CHIPKIT3DP-TEAM/mchp_kossel/shield pinout.ods

Sheet: Shield
CHIPKIT RAMPS MINI
chipKIT Pin # | Connector Pin # | PIN# | WIFIRE Signal | UNO32 Signal | RAMP Signal | Notes | Ramps mini HW | HW Design Notes
0 | J6-01 | 57 | RF2,GPIO,U4RX | U1RX/SDI1/RF2 |  |  | 4x A4983 Steppers | Steppers are configured 16 micro steps
1 | J6-03 | 58 | RF8,GPIO,U4TX | U1TX/SDO1/RF3 |  |  | 1x 24AA08 EEPROM | All steppers are enabled together
2 | J6-05 | 18 | RE8,GPIO,IC1,INT1 | IC1/RTCC/INT1/RD8 | Dir A |  | 1x MCP47FEB02 2-chn DAC | All steppers are reset from RESET
3 | J6-07 | 71 | RD0,PWM1, INT0,OC1 | OC1/RD0 | Step A | Output compare for step generator | 4x MCP87055 MOSFETs | Output Compares are reserved for the steppers
4 | J6-09 | 60 | RA3,GPIO | RF1 | Dir B | 3.3v GPIO | 3x FSR Inputs | 1 PWM is available for the print fan
5 | J6-11 | 76 | RD1,PWM2, OC2 | OC2/RD1 | Step B | Output compare for step generator | 2x Thermistor Inputs | 1 GPIO is available for the hot end fan (no pwm on uno32)
6 | J6-13 | 77 | RD2,PWM3, OC3 | OC3/RD2 | Step C | Output compare for step generator | 3x Limit Inputs (5v drive) | Thermistors are pulled up to 3.3v
7 | J6-15 | 19 | RE9,GPIO,IC2,INT2 | IC2/U1CTS/INT2/RD9 | Dir C | 3.3v GPIO | 1x Servo Inputs (5v power) | Servo is pulled up to 5v
8 | J5-01 | 66 | RA14,GPIO,IC3,INT3 | IC3/PMCS2/PMA15/INT3/RD10 | Dir E | 3.3v GPIO | Legacy LCD Ctrl support | FSR's and endstops are pulled up to 5v or 3.3v via jumper
9 | J5-03 | 78 | RD3,PWM4,OC4 | OC4/RD3 | Step E | Output compare for step generator | 1x MCP9800 near MOSFETS | DAC's to set motor current, separate motion / extruder
10 | J5-05 | 16 | RG9,SPI_SS2,PWM5,OC9,IC6 | (PMWR/OC5/IC5/CN13/RD4) or (SS2/PMA2/CN11/RG9) | Fan PWM | PWM For Fan Control | 1x MCP9800 near Steppers | Serial EEPROM for configuration
11 | J5-07 | 70 | RD11,SPI_SDO2/SDI2, PWM6, OC7 | (SDO2/PMA3/CN10/RG8) or (SDI2/PMA5/CN8/RG7) | SD SDO | SPI for LCD Display |  | 1 serial expansion bus for extra hot-ends
12 | J5-09 | 85 | RF0,SPI_SDI2/SDO2,T5CK(+) | (SDI2/PMA5/CN8/RG7) or (SDO2/PMA3/CN10/RG8) | SD SDI | Could be SPI controlled TFT with Touch
13 | J5-11 | 10 | RG6,SPI_SCK2,USER_LED1 | SCK2/PMA5/CN8/RG6 | SD SCK | Or it could be Ultimachine 4 line display with buttons
14/A0 | J7-01 | 20 | RB5,AN45,GPIO | C2IN-/AN2/SS1/CN4/RB2 | SD nCS
15/A1 | J7-03 | 33 | RB9,AN49,GPIO | C1IN-/AN4/CN6/RB4 | Bed Thermistor
16/A2 | J7-05 | 7 | RC2,AN21,GPIO | U2CTS/C1OUT/AN8/RB8 | Hot End Thermistor
17/A3 | J7-07 | 44 | RB15,AN10 | TMS/CVREFOUT/PMA13/AN10/RB10 | SDA / SD DETECT | Crazy jumpers required | I2C has 3.3v pullup
18/A4 | J7-09 | 11 | RG7,AN13,SDA | (TCK/PMA11/AN12/RB12) or (SDA1/RG3)(TCK/PMA11/AN12/RB12) or (SDA1/RG3) | SCL / SDA | to configure this I2C
19/A5 | J7-11 | 12 | RG8,AN12,GPIO,SCL | (PMALH/PMA1/U2RTS/AN14/RB14) or (SCL1/RG2)(PMALH/PMA1/U2RTS/AN14/RB14) or (SCL1/RG2) | SD DETECT / SCL
20/A6 | J7-02 | 22 | RB3,AN3,GPIO | C2IN+/AN3/CN5/RB3 | FSR / Min A | ADC inputs to Force Sensing Resistors | FSR's & Thermistors have 3.3v pullups
21/A7 | J7-04 | 23 | RB2,AN2,GPIO | C1IN+/AN5/CN7/RB5 | FSR / Min B | ADC inputs to Force Sensing Resistors
22/A8 | J7-06 | 21 | RB4,AN4,GPIO | PMA7/C2OUT/AN9/RB9 | FSR / Min C | ADC inputs to Force Sensing Resistors
23/A9 | J7-08 | 24 | RB1,AN1,GPIO | TDO/PMA12/AN11/RB11 | Encoder 0 / LCD Touch X | Resistive Touch Screen Input
24/A10 | J7-10 | 32 | RB8,AN48,GPIO, P32_VBUS_ON | TDI/PMA10/AN13/RB13 | Encoder 1 / LCD Touch Y | Resisitive Touch Screen Input
25/A11 | J7-12 | 25 | RB0,AN0,GPIO | PMALL/PMA0/AN15/OCFB/CN12/RB15 | Encoder Select
26 | J6-02 | 91 | RE0,PMD0 | PMD0/RE0 | LCD D4
27 | J6-04 | 94 | RE1,PMD1 | PMD1/RE1 | LCD D5
28 | J6-06 | 98 | RE2,PMD2 | PMD2/RE2 | LCD D6
29 | J6-08 | 99 | RE3,PMD3 | PMD3/RE3 | LCD D7
30 | J6-10 | 100 | RE4,PMD4 | PMD4/RE4 | LCD RS
31 | J6-12 | 3 | RE5,PMD5 | PMD5/RE5 | LCD EN
32 | J6-14 | 4 | RE6,PMD6 | PMD6/RE6 | Servo
33 | J6-16 | 5 | RE7,PMD7 | PMD7/RE7 | Stepper Enable
34 | J5-02 | 82 | RD5,GPIO, T4CK | PMRD/CN14/RD5 | Max C
35 | J5-04 | 6 | RC1,GPIO, T2CK, IC7 | IC4/PMCS1/PMA14/INT4/RD11 | Max B
36 | J5-06 | 86 | RF1,GPIO, T6CK | CN15/RD6 | Max A
37 | J5-08 | 59 | RA2,GPIO | CN16/RD7 | Fan DC
38 | J5-10 | 79 | RD12,GPIO, T3Ck | U1RTS/BCLK1/SCK1/INT0/RF6 | Heater Bed
39 | J5-12 | 47 | RD14,GPIO,U1RX | PMA9/U2RX/SDA2/CN17/RF4 | Serial Bus Expansion RX | 3-pin & Display Connector | Question… Should serial expansion be differential (485)
40 | J5-14 | 48 | RD15,GPIO, U1TX | PMA8/U2TX/SCL2/CN18/RF5 | Serial Bus Expansion TX |  | If YES, should DE & RE be connected to SDI/SDO for when digipots are not being talked to.
41 | J5-16 | 28 | RA9,GPIO, VREF- | PGC1/AN1/VREF-/CVREF-/CN3/RB1 | Heater Extr |  | I.E. you cannot talk to the BUS & the Digipot at the same time.
42 | J5-15 | 29 | RA10,VREF+ | PGED1/PMA6/AN0/VREF+/CVREF+/CN2/RB0 | Vdd/4 | Thermistor GAIN
43 |  | 81 | RD4,USER_LED2 | RF0

Sheet: WiFire
pin | shield | onboard | 3dp
TMS/EBIA16/AN24/RA0 |  | JP3-JTAG
TCK/EBIA19/AN29/RA1 |  | JP3-JTAG
EBICS0/SCL2/RA2 | J7-D37 |  | FAN_DC
EBIRDY1/SDA2/RA3 | J10-D4 |  | DIR_B
EBIA14/PMCS1/PMA14/RA4 |  | BTN2
EBIA5/AN34/PMA5/RA5 |  | BTN1
TRCLK/SQICLK/RA6 |  | JP4-TRACE
TRD3/SQID3/RA7 |  | JP4-TRACE
VREF-/CVREF-/AN27/AERXD2/RA9 | J7-D41 |  | HEAT_EXT
VREF+/CVREF+/AN28/AERXD3/RA10 | J7-AREF |  | AREF
AETXCLK/RPA14/SCL1/RA14 | J7-D8 | VBUS OVC | DIR_E
AETXEN/RPA15/SDA1/RA15 |  | MRF-INT
PGED1/AN0/RPB0/RB0 | J8-A11 | VBUS-EN | ENC_SEL
PGEC1/AN1/RPB1/RB1 | J8-A9 |  | ENC_0
AN2/C2INB/RPB2/RB2 | J8-A7 |  | MIN_B
AN3/C2INA/RPB3/RB3 | J8-A6 |  | MIN_A
AN4/C1INB/RB4 | J8-A8 |  | MIN_C
AN45/C1INA/RPB5/RB5 | J8-A0 |  | SD_CS
PGEC2/AN46/RPB6/RB6 |  | PGC
PGED2/AN47/RPB7/RB7 |  | PGD
EBIA10/AN48/RPB8/PMA10/RB8 | J8-A10 |  | ENC_1
EBIA7/AN49/RPB9/PMA7/RB9 | J8-A1 |  | THERMO_BED
EBIA13/CVREFOUT/AN5/RPB10/PMA13/RB10 |  | SD-SDI
AN6/ERXERR/AETXERR/RB11 |  | LED3
EBIA11/AN7/ERXD0/AECRS/PMA11/RB12 |  | VBUS SNS
AN8/ERXD1/AECOL/RB13 |  | POT-VR1
EBIA1/AN9/ERXD2/AETXD3/RPB14/SCK3/PMA1/RB14 |  | SD-SCK
EBIA0/AN10/ERXD3/AETXD2/RPB15/OCFB/PMA0/RB15 | J8-A3 |  | SD_DETECT
EBIA6/AN22/RPC1/PMA6/RC1 | J7-D35 |  | MAX_B
EBIA12/AN21/RPC2/PMA12/RC2 | J8-A2 |  | THERMO_EXT
EBIWE/AN20/RPC3/PMWR/RC3 |  | SD-CS
EBIOE/AN19/RPC4/PMRD/RC4 |  | SD-SDO
OSC1/CLKI/RC12 |  | POSC
SOSCI/RPC13/RC13 |  | SOSC
SOSCO/RPC14/T1CK/RC14 |  | SOSC
OSC2/CLKO/RC15
EMDIO/AEMDIO/RPD0/RTCC/INT0/RD0 | J10-D3 |  | STEP_A
RPD1/SCK1/RD1 | J10-D5 |  | STEP_B
EBID14/ETXEN/RPD2/PMD14/RD2 | J10-D6 |  | STEP_C
EBID15/ETXCLK/RPD3/PMD15/RD3 | J7-D9 |  | STEP_E
SQICS0/RPD4/RD4 |  | LED2
SQICS1/RPD5/RD5 | J7-D34 |  | MAX_C
EBIA15/RPD9/PMCS2/PMA15/RD9 |  | MRF-CS
RPD10/SCK4/RD10 |  | MRF-SCK
EMDC/AEMDC/RPD11/RD11 | J7-D11 | J9-SPI | SPI_SDO
EBID12/ETXD2/RPD12/PMD12/RD12 | J7-D38 |  | HEAT_BED
EBID13/ETXD3/PMD13/RD13 |  | EN-EXT
AN32/AETXD0/RPD14/RD14 | J7-D39 |  | BUS_RX
AN33/AETXD1/RPD15/SCK6/RD15 | J7-D40 |  | BUS_TX
EBID0/PMD0/RE0 | J10-D26 |  | LCD_D4
EBID1/PMD1/RE1 | J10-D27 |  | LCD_D5
EBID2/PMD2/RE2 | J10-D28 |  | LCD_D6
EBID3/RPE3/PMD3/RE3 | J10-D29 |  | LCD_D7
EBID4/AN18/PMD4/RE4 | J10-D30 |  | LCD_RS
EBID5/AN17/RPE5/PMD5/RE5 | J10-D31 |  | LCD_EN
EBID6/AN16/PMD6/RE6 | J10-D32 |  | SERVO
EBID7/AN15/PMD7/RE7 | J10-D33 |  | STEPPER_EN
AN25/AERXD0/RPE8/RE8 | J10-D2 |  | DIR_A
AN26/AERXD1/RPE9/RE9 | J10-D7 |  | DIR_C
EBID11/ETXD1/RPF0/PMD11/RF0 | J7-D12 | J9-SPI | SPI_SDI
EBID10/ETXD0/RPF1/PMD10/RF1 | J7-D36 |  | MAX_A
EBIRDY3/RPF2/SDA3/RF2 | J10-D0 | FTDI-RX
USBID/RPF3/RF3 |  | USB-ID
EBIA9/RPF4/SDA5/PMA9/RF4 |  | MRF-RST
EBIA8/RPF5/SCL5/PMA8/RF5 |  | MRF-SDI
EBIRDY2/RPF8/SCL3/RF8 | J10-D1 | FTDI-TX
TDO/EBIA17/AN31/RPF12/RF12 |  | JP3-JTAG
TDI/EBIA18/AN30/RPF13/SCK5/RF13 |  | JP3-JTAG
EBID8/RPG0/PMD8/RG0 |  | MRF-SDO
EBID9/ETXERR/RPG1/PMD9/RG1 |  | MRF-PD
AN14/C1IND/ECOL/RPG6/SCK2/RG6 | J7-D13 | J9-SPI / LED1 | SPI_SCK
EBIA4/AN13/C1INC/ECRS/RPG7/SDA4/PMA4/RG7 | J6-A4 | J6-I2C | I2C_SDA
EBIA3/AN12/C2IND/ERXDV/ECRSDV/AERXDV/AECRSDV/RPG8/SCL4/PMA3/RG8 | J6-A5 | J6-I2C | I2C_SCL
EBIA2/AN11/C2INC/ERXCLK/EREFCLK/AERXCLK/AEREFCLK/RPG9/PMA2/RG9 | J7-D10 | J9-SPI | FAN_PWM
TRD1/SQID1/RG12 |  | JP4-TRACE
TRD0/SQID0/RG13 |  | JP4-TRACE
TRD2/SQID2/RG14 |  | JP4-TRACE
AN23/AERXERR/RG15 |  | LED4
