CHIPKIT3DP-TEAM/mchp_kossel/board/output/shield3dp-A0.bom.pdf

| Value | Count | Source
A4988 QFN | A4988SETTR-T | 4
BTN 6X6 | | 1
CAP C 0603 | 0.1u | 14
CAP C 0603 | 0.33u | 4
CAP C 0603 | 1u | 7
CAP C 0603 | 1u 16V | 8
CAP C 0603 | 10n | 8
CAP C 0805 | 10u | 4
CAP C 1206 | 1u 25V | 1
CAP C 1206 | 10u 16V | 1
CAP E THM200 D400 | 470u 16V | 1
LED 0603 | | 2
MCP47FEBX2 | MCP47FEB02A0T-E/ST | 1 | MCHP
MCP87XXX 3.3X3.3 | MCP87055T-U/LC | 4 | MCHP
MCP980X SOT23-5 | MCP9800A0T-M/OT | 1 | MCHP
MCP98244 | MCP98244T-BE/MNY | 1 | MCHP
NPN SOT23 | BC847C | 1
PIN100 2 | | 3
PIN100 2 | THERMO | 2
PIN100 3 | ENDSTOP | 6
PIN100 3 | | 4
PIN100 4 | STEPPER | 4
PIN100 5X2 | EXPANSION | 2
PIN100 6 | POWER | 1
PIN100 6X2 | ANALOG | 1
PIN100 8X2 | IOH | 1
PIN100 8X2 | IOL | 1
PIN150 2 | FAN | 2
PIN150 3 | BUS | 1
PIN200 2 | HIGH POWER | 3
RES 0603 | 0.1 | 8 | DIGIKEY 1276-6155-1-ND
RES 0603 | 1K | 4
RES 0603 | 3.3K | 3
RES 0603 | 4.7K | 8
RES 0603 | 10K | 5
RES 0603 | 100 | 7
FUSE THM200 | 15V 8A | 1
FUSE THM400 | 15V 15A | 1
SHOTTKY 0603 | 20V 200mA | 4
SHOTTKY SMD200 | 20V 5A | 3

ComponentName

DigiKey 620-1343-1-ND

DigiKey WM4800-ND + WM2900-ND DigiKey WM4801-ND + WM2901-ND

DigiKey WM4802-ND + WM2902-ND

DigiKey 507-1309-ND
DigiKey RGEF1400-ND
DigiKey 478-7798-1-ND
DigiKey DB2431200LCT-ND
