CHIPKIT3DP-TEAM/mchp_kossel/3D_Kossel_Hardware_BOM.ods

Sheet: Summary
Item | Discription | QTY | Base cost | Total | Weight (KG) | SKU | Link
1 | Tr8*8 500mm Leadscrew Threaded Stepper | 3 | $51.00 | $153.00 | 0.41 |  | http://www.robotdigg.com/product/227/500mm-Tr8*8-Lead-Screw-Threaded-Nema17-40mm-Stepper
2 | All Metal hotend w/0.4mm nozzle for 1.75mm filament | 1 | $36.00 | $36.00 | 0.1 | S0004 | http://www.robotdigg.com/product/182/All-metal-hotend-w/-0.4mm-nozzle-for-1.75mm-filament
3 | Tie Rod n Ball Joint Pack Set (12pcs) | 1 | $7.00 | $7.00 | 0.01 | DR001 | http://www.robotdigg.com/product/75/Tie-Rod-n-Ball-Joint-Pack-Set
4 | China Made MGN-12H L400 hardened Steel Rail and Carriage for Kossel | 1 | $58.00 | $58.00 | 1.4 | DR009 | http://www.robotdigg.com/product/164/China-Made-MGN-12H-L400-hardened-Steel-Rail-and-Carriage-for-Kossel
5 | Post Assembly T Nuts for 2020 Aluminum Extrustion (100pcs) (Request M4) | 1 | $7.50 | $7.50 | 0.1 | DR015 | http://www.robotdigg.com/product/237/Post-Assembly-T-Nuts-for-2020-Aluminum-Extrusion
6 | Post Assembly T Nuts for 2020 Aluminum Extrustion (100pcs) (Request M3) | 1 | $7.50 | $7.50 | 0.1 | DR015 | http://www.robotdigg.com/product/237/Post-Assembly-T-Nuts-for-2020-Aluminum-Extrusion
7 | Carbon Fiber Tube, 5mm OD, 3mm ID, 180mm L (6pcs) | 1 | $5.00 | $5.00 | 0.01 | DR007 | http://www.robotdigg.com/product/187/Carbon-Fiber-Tube,-5mm-OD,-3mm-ID,-180mm-L-%286pcs%29
8 | 180mm round Silicone Ruber Heater Pad | 1 | $12.80 | $12.80 | 0.2 | DR016 | http://www.robotdigg.com/product/238/180mm-round-silicone-rubber-heater-pad
9 | 180mm Round Glass | 1 | $8.00 | $8.00 | 0.2 | DR013 | http://www.robotdigg.com/product/200/Round-Glass-180mm-for-Kossel-Mini
10 | 2020 OpenBeam (15mm x 15 mm) | 1 | $24.00 | $24.00 | 1.85 | DR011 | http://www.robotdigg.com/product/183/2020-OpenBeam-for-Kossel-Mini
11 | Optical Endstops w/ Lead Wires for 3D Printers | 3 | $2.00 | $6.00 | 0.01 | E001 | http://www.robotdigg.com/product/155/Optical-Endstop-w/-Lead-Wires-for-3D-Printers
12 | NEMA 17 40mm | 1 | $6.80 | $6.80 |  |  | http://www.robotdigg.com/product/7/NEMA17-Stepper-Motor-40mm-Long,-1.2A
13 | PTFE Tube 2mm ID, 3mm OD, 2M | 1 | $1.80 | $1.80 |  |  | http://www.robotdigg.com/product/93/ID-2mm,-OD-3mm-PTFE-Tube-2-Meters
14 | 8mm Spiral cable Wrap black or white (10 meters) | 1 | 1 | $1.00 |  |  | http://www.robotdigg.com/product/196/8mm-spiral-cable-wrap-black-or-white
15 | M3*4 Grub Screw Pack | 1 | $0.35 | $0.35 |  |  | http://www.robotdigg.com/product/17/M3*4-Grub-Screw-PACK-SET-for-Timing-Pulleys
16 | PC4-01 Pneumatic Connector (Must Request the -01) | 1 | 0.3 | $0.30 |  |  | http://www.robotdigg.com/product/135/PC4-M6-Pneumatic-Connector-for-Bowden-Extruder
17 | Hobbed M8 Bolt | 1 | $2.80 | $2.80 |  |  | http://www.robotdigg.com/product/156/Hobbed-M8-Bolt-for-Wade's-Extruder
18 | M4-0.7 x 12mm (100pcs) | 1 | $6.14 | $6.14 |  |  | http://www.amazon.com/gp/product/B00DD4UYQU?ref_=biss_dp_sa1&pldnSite=1
19 | M4-0.7 x 25mm (100pcs) | 1 | 6.6 | $6.60 |  |  | http://www.amazon.com/gp/product/B00DD4UYQU?ref_=biss_dp_sa1&pldnSite=1
20 | eTopLED 12v 15.5A Single Output Switching Low-cost Power Supply | 1 | $19.79 | $19.79 |  |  | http://www.amazon.com/gp/product/B00DR8V8DA?pldnSite=1
Sum Per Kit |  |  |  | $370.38
Number Of Kits |  |  |  | 1
Total |  |  |  | $370.38

Sheet: Screws
assembly | M4-8 | M4-12 | M4-25 | M3-8 | M3-20 | M3-70
spool holder |  | 4 | 1
extruder mount |  | 2
extruder motor |  |  |  | 4
top plate |  | 9
top corners |  | 12 | 6
end stops |  |  |  | 6
rails |  |  |  | 15
carriages |  |  |  | 15
beams |  |  |  |  | 12
hot end + fan mount |  |  |  |  |  | 4
fan |  |  |  |  | 4
building deck | 9
motors |  |  |  | 16
bottom corners |  | 24 | 24
PSU, fan |  |  |  | 4 | 4
bottom plate |  | 9
overall | 9 | 60 | 31 | 60 | 20 | 4
order | 10 | 100 | 50 | 100 | 25 | 5
