CHIPKIT3DP-TEAM/mchp_kossel/Printer/acrylic/large wall.dxf

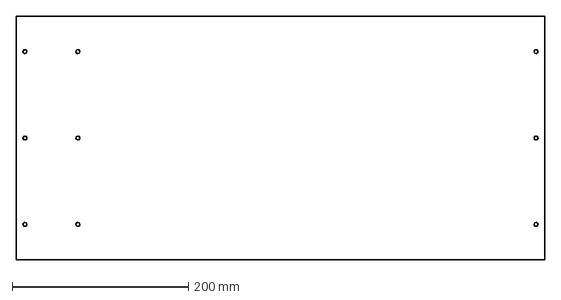
[picture p2: CAD file, 2015-05-05]
Printer/acrylic/large wall.dxf
600.0 x 276.1 mm
