CHIPKIT3DP-TEAM/mchp_kossel/Printer/effector/j-head mount.stl

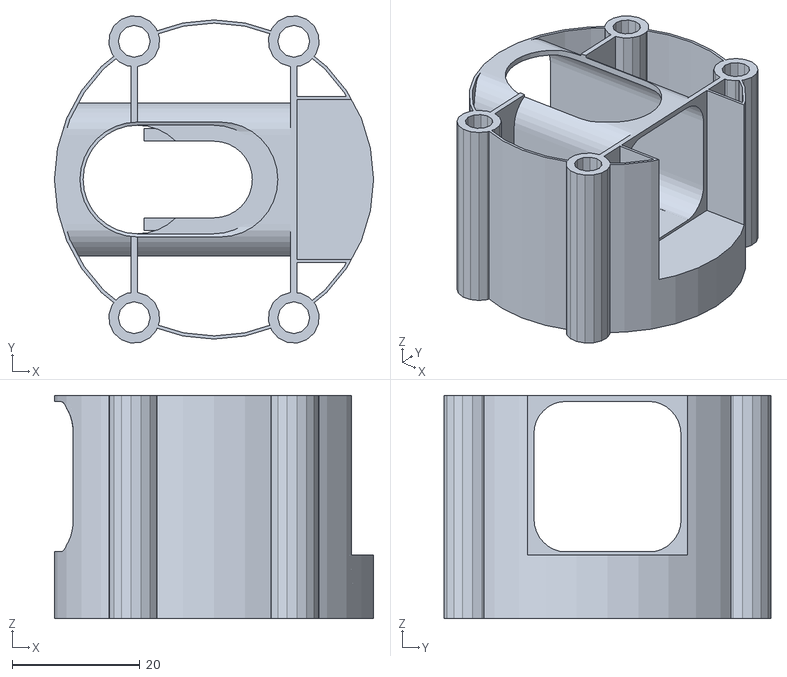
[picture p3: CAD file, 2015-08-30]
Printer/effector/j-head mount.stl
50.0 x 51.2 x 35.0
