CHIPKIT3DP-TEAM/mchp_kossel/Printer/extruder/extr_gear_big_43.stl

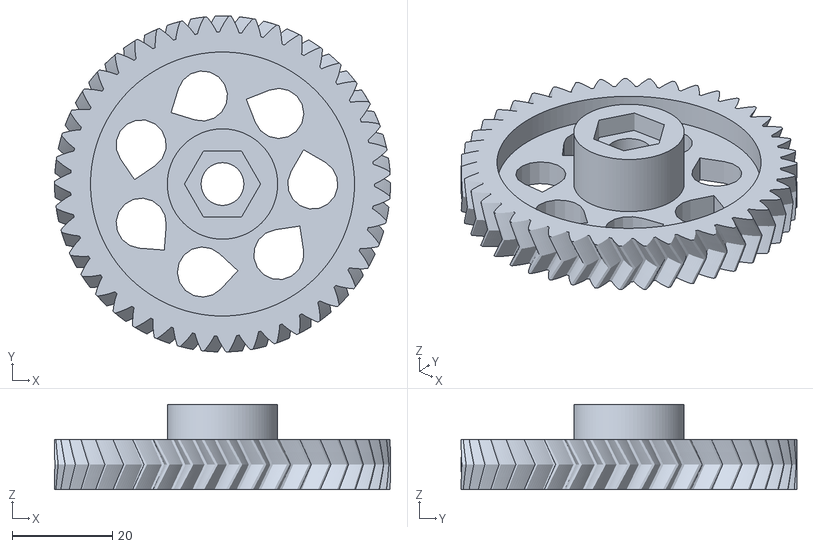
[picture p4: CAD file, 2015-06-20]
Printer/extruder/extr_gear_big_43.stl
67.0 x 67.0 x 17.0
