CHIPKIT3DP-TEAM/mchp_kossel/Printer/top corner notch.stl

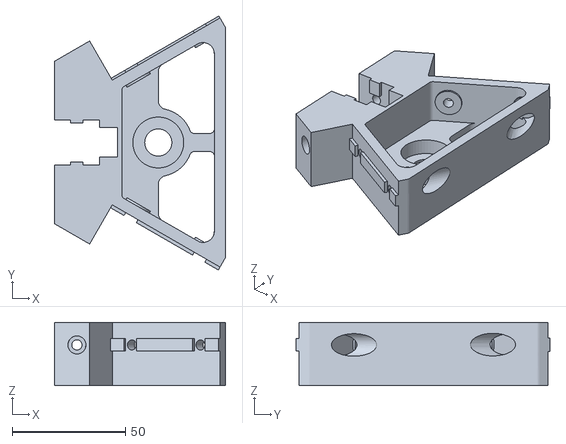
[picture p5: CAD file, 2015-08-12]
Printer/top corner notch.stl
75.8 x 112.3 x 28.0
