CHIPKIT3DP-TEAM/mchp_kossel/Printer/acrylic/insulator.dxf

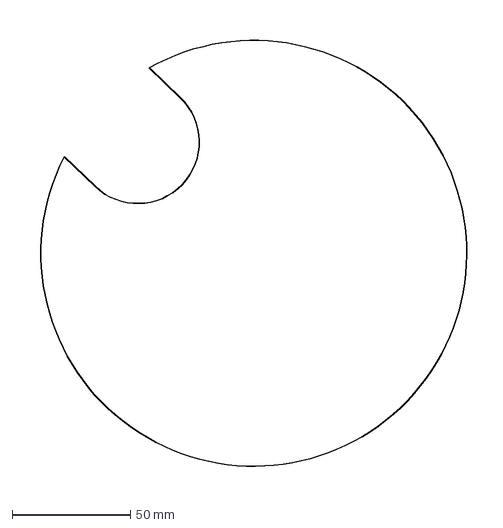
[picture p6: CAD file, 2015-05-05]
Printer/acrylic/insulator.dxf
198.9 x 199.5 mm
