CHIPKIT3DP-TEAM/mchp_kossel/Printer/cable clamp 5mm.stl

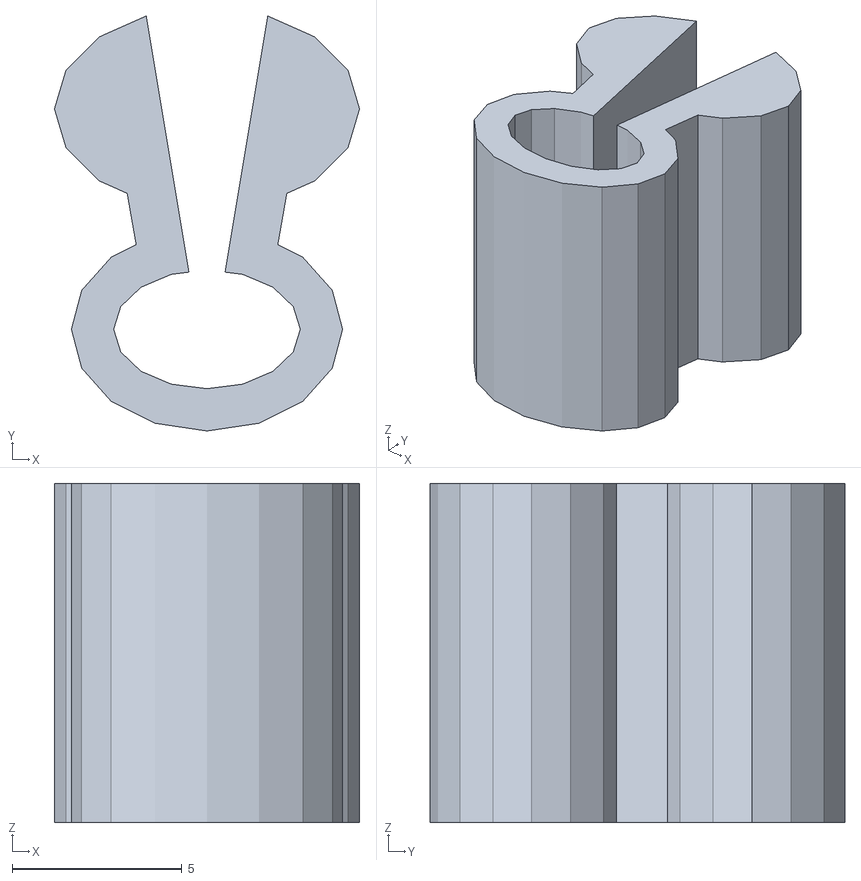
[picture p7: CAD file, 2015-05-14]
Printer/cable clamp 5mm.stl
9.00 x 12.2 x 10.0
