CHIPKIT3DP-TEAM/mchp_kossel/Printer/effector/ubis mount.stl

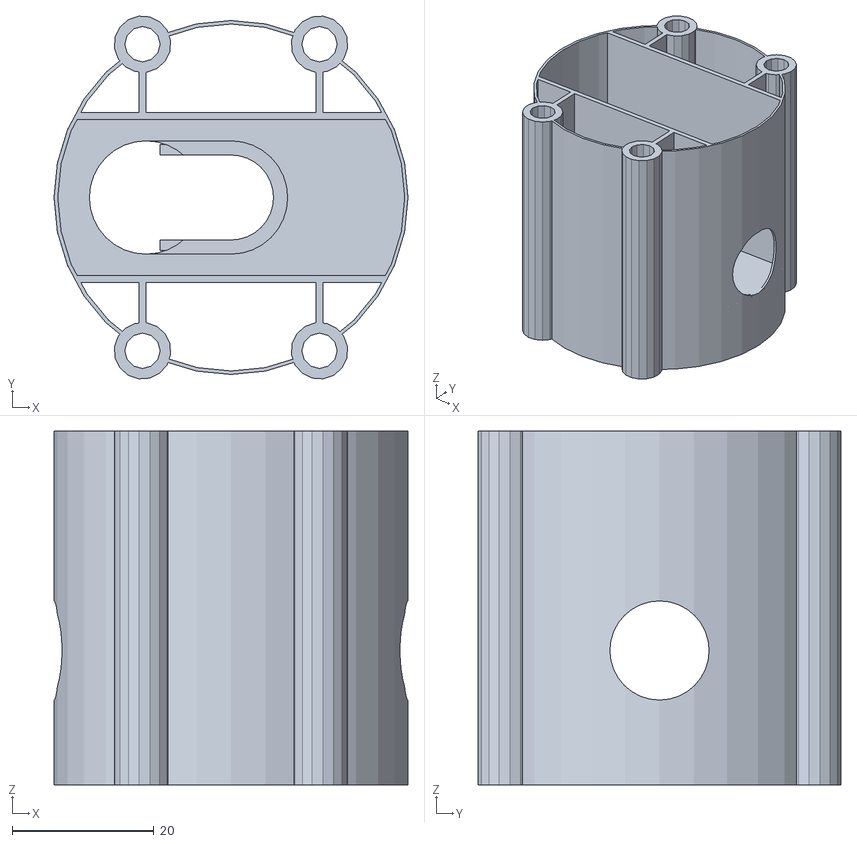
[picture p8: CAD file, 2015-08-30]
Printer/effector/ubis mount.stl
50.0 x 51.2 x 50.0
