CHIPKIT3DP-TEAM/mchp_kossel/Printer/extruder/extr_body.stl

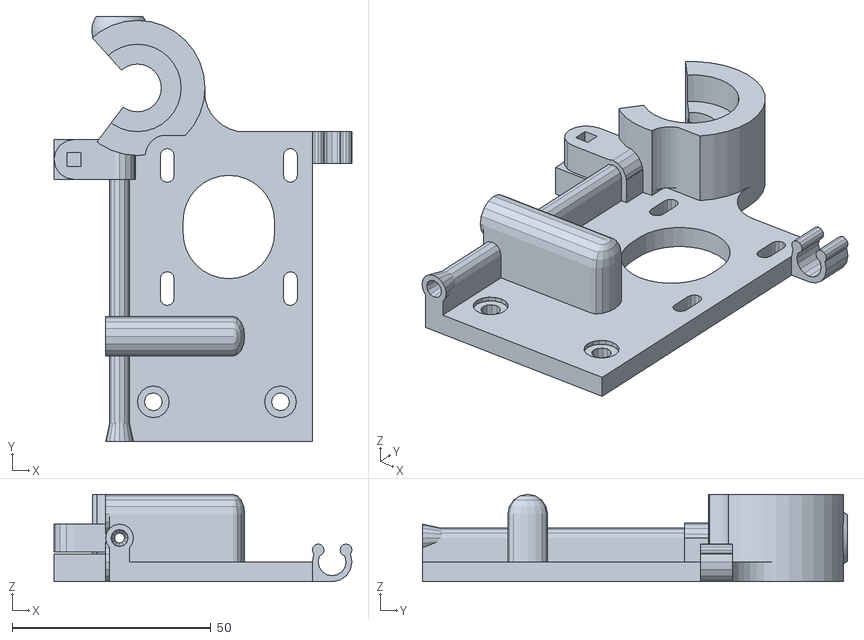
[picture p9: CAD file, 2015-06-02]
Printer/extruder/extr_body.stl
75.0 x 107.0 x 22.0
