CHIPKIT3DP-TEAM/mchp_kossel/Printer/acrylic/top plate.dxf

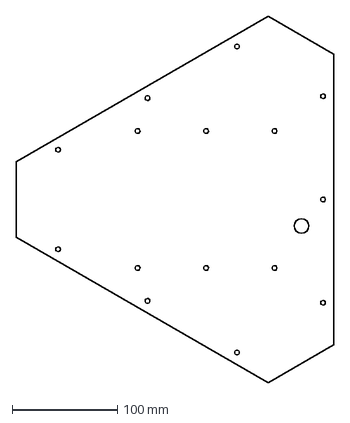
[picture p10: CAD file, 2015-05-05]
Printer/acrylic/top plate.dxf
301.2 x 347.8 mm
