CHIPKIT3DP-TEAM/mchp_kossel/Printer/cable clamp 10mm.stl

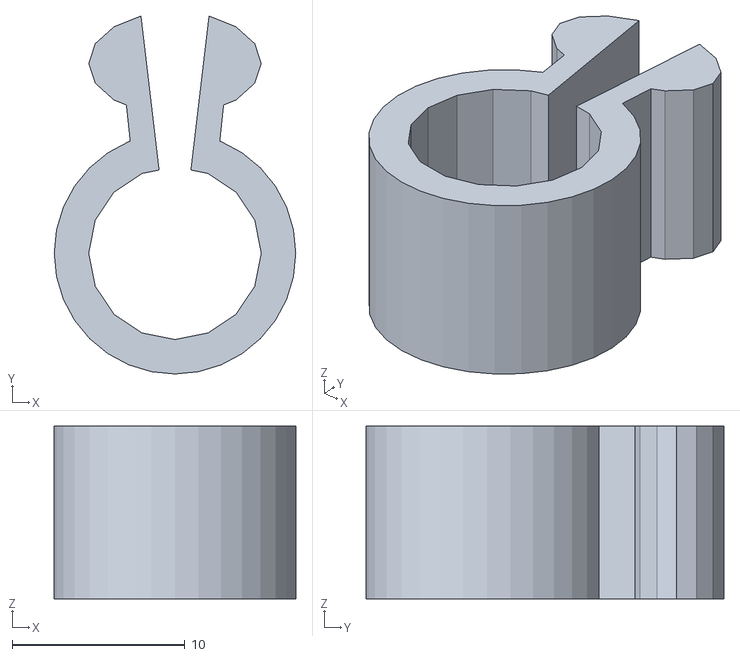
[picture p11: CAD file, 2015-05-12]
Printer/cable clamp 10mm.stl
14.0 x 20.7 x 10.0
