CHIPKIT3DP-TEAM/mchp_kossel/Printer/effector/effector plate.stl

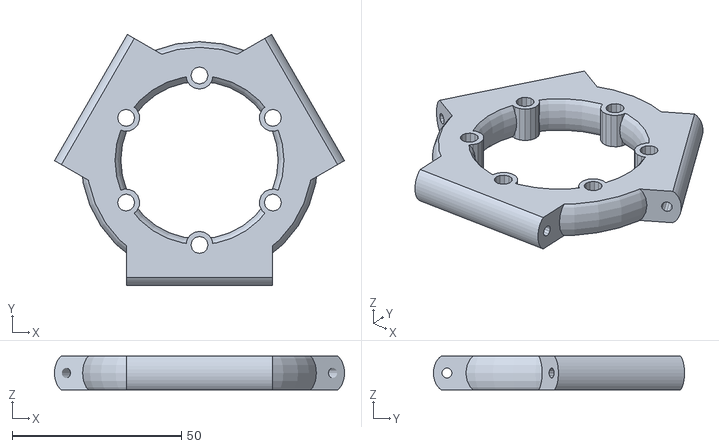
[picture p12: CAD file, 2015-08-30]
Printer/effector/effector plate.stl
85.6 x 74.1 x 9.99
