CHIPKIT3DP-TEAM/mchp_kossel/Printer/extruder/extr_gear_small_13.stl

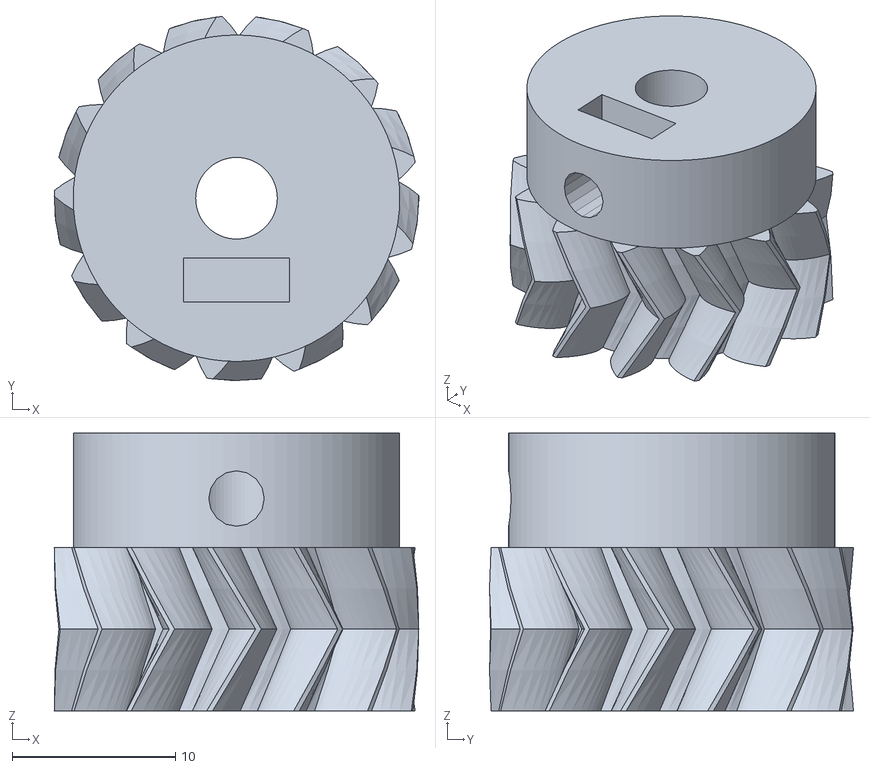
[picture p13: CAD file, 2015-05-12]
Printer/extruder/extr_gear_small_13.stl
22.3 x 22.3 x 17.0
