CHIPKIT3DP-TEAM/mchp_kossel/Printer/acrylic/build deck.dxf

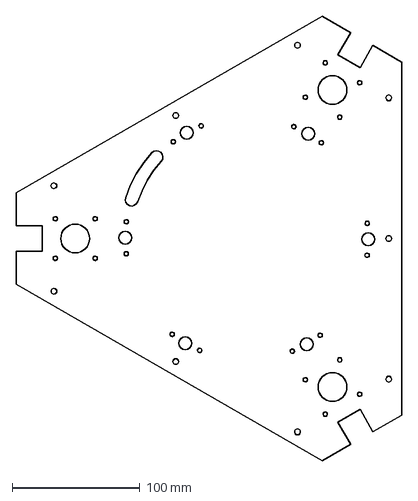
[picture p14: CAD file, 2015-05-05]
Printer/acrylic/build deck.dxf
301.2 x 347.8 mm
