CHIPKIT3DP-TEAM/mchp_kossel/Printer/carraige.stl

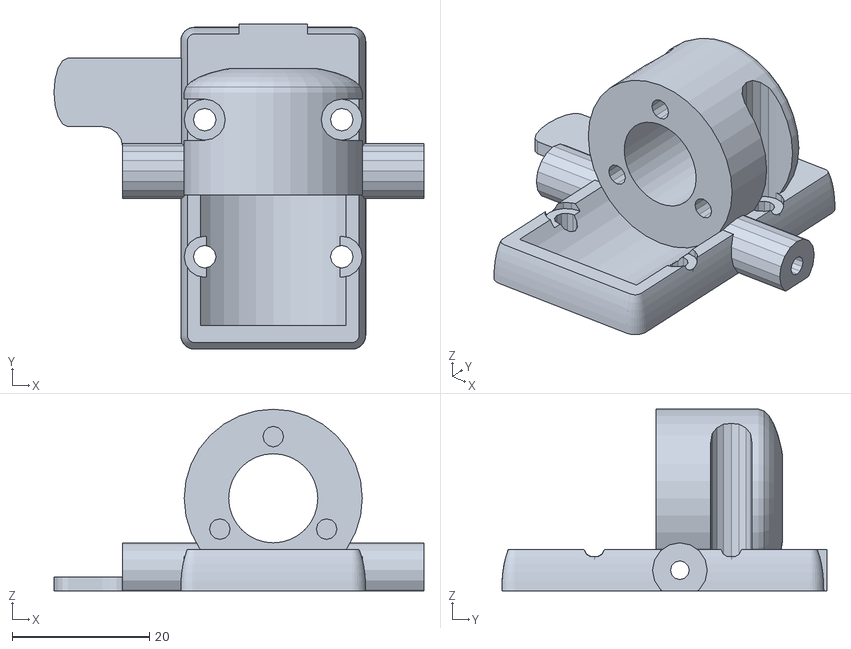
[picture p15: CAD file, 2015-05-12]
Printer/carraige.stl
54.0 x 47.5 x 26.5
