CHIPKIT3DP-TEAM/mchp_kossel/Printer/effector/e3d mount.stl

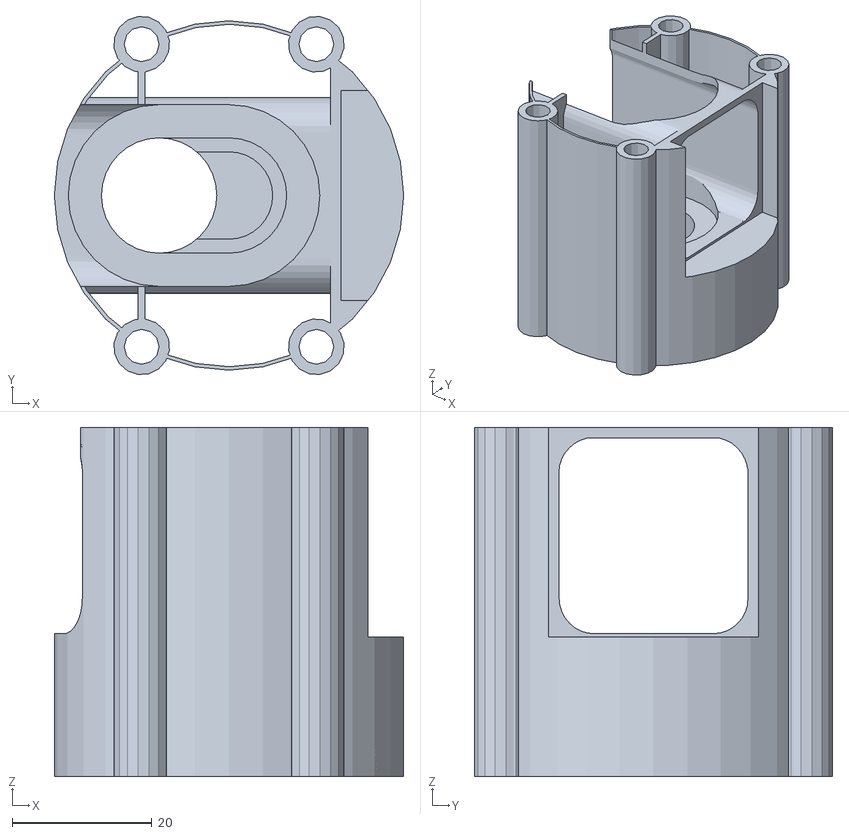
[picture p16: CAD file, 2015-08-30]
Printer/effector/e3d mount.stl
50.0 x 51.2 x 50.0
