CHIPKIT3DP-TEAM/mchp_kossel/Printer/extruder/extr_lever.stl

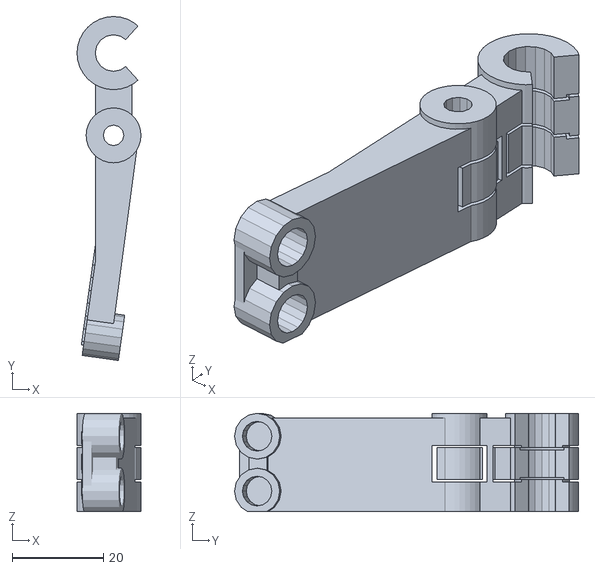
[picture p17: CAD file, 2015-02-27]
Printer/extruder/extr_lever.stl
14.0 x 75.3 x 21.5
