CHIPKIT3DP-TEAM/mchp_kossel/Printer/acrylic/bottom plate.dxf

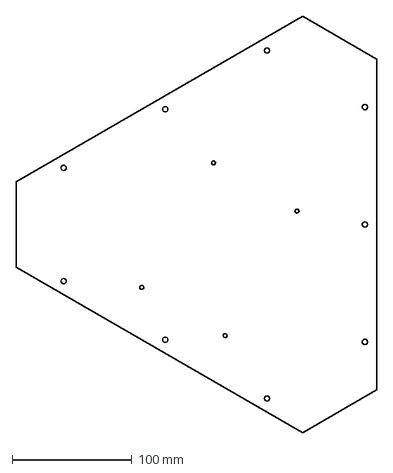
[picture p18: CAD file, 2015-05-05]
Printer/acrylic/bottom plate.dxf
301.2 x 347.8 mm
