CHIPKIT3DP-TEAM/mchp_kossel/Printer/effector/e3d plug.stl

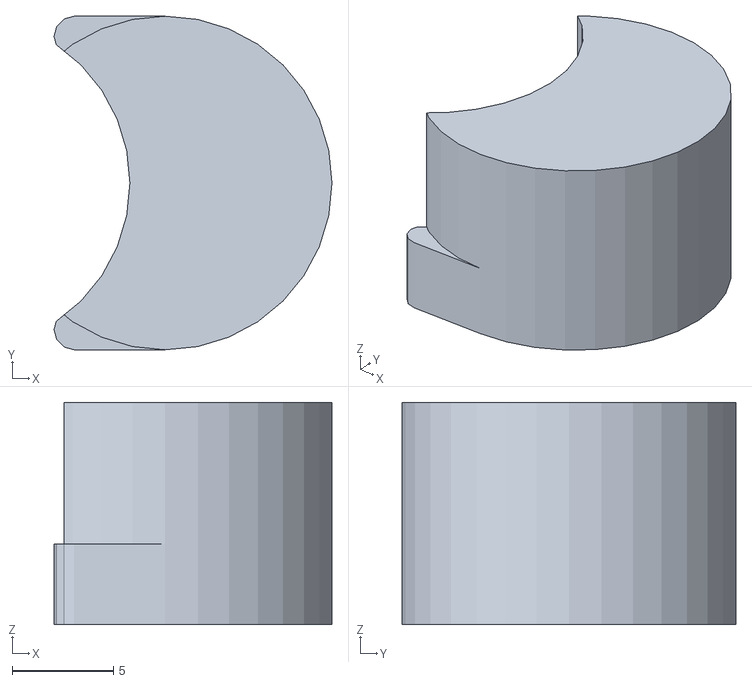
[picture p19: CAD file, 2015-06-20]
Printer/effector/e3d plug.stl
13.8 x 16.5 x 11.0
