CHIPKIT3DP-TEAM/mchp_kossel/Printer/extruder/extr_pin.stl

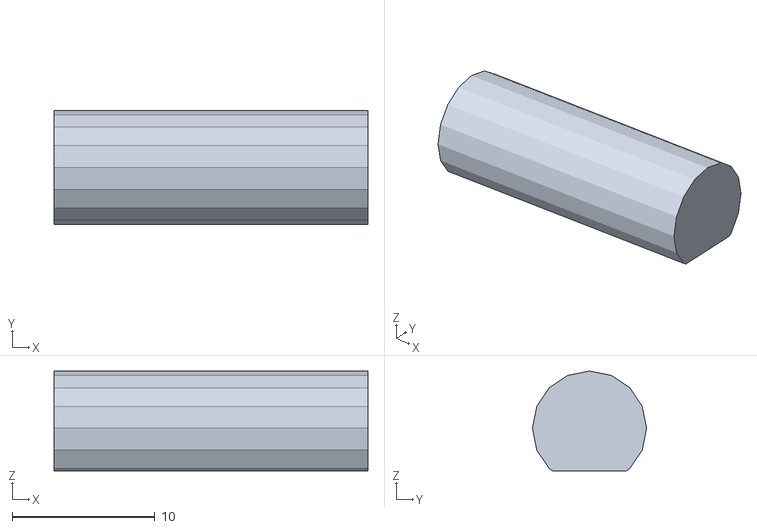
[picture p20: CAD file, 2015-02-24]
Printer/extruder/extr_pin.stl
22.0 x 8.00 x 7.00
