CHIPKIT3DP-TEAM/mchp_kossel/Printer/acrylic/small wall.dxf

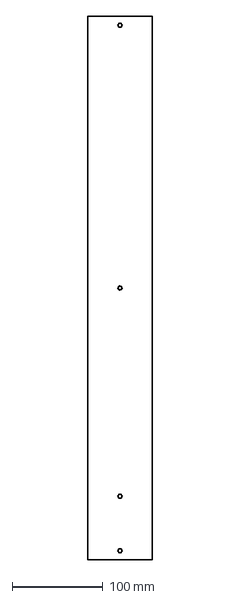
[picture p21: CAD file, 2015-05-05]
Printer/acrylic/small wall.dxf
71.7 x 600.0 mm
