CHIPKIT3DP-TEAM/mchp_kossel/Printer/effector/j-head plug.stl

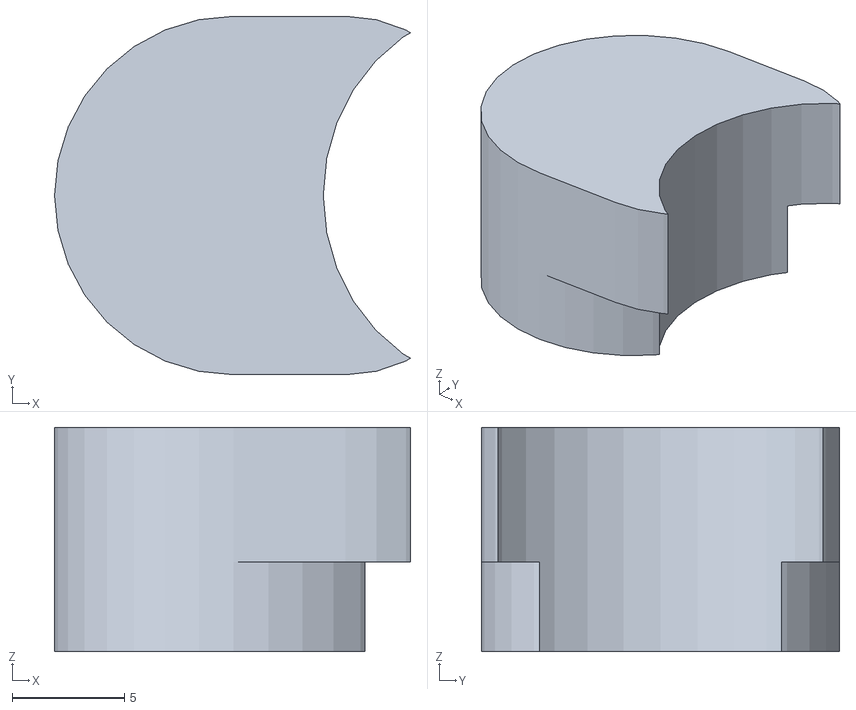
[picture p22: CAD file, 2015-05-22]
Printer/effector/j-head plug.stl
15.9 x 16.0 x 10.0
