CHIPKIT3DP-TEAM/mchp_kossel/Printer/harness clip.stl

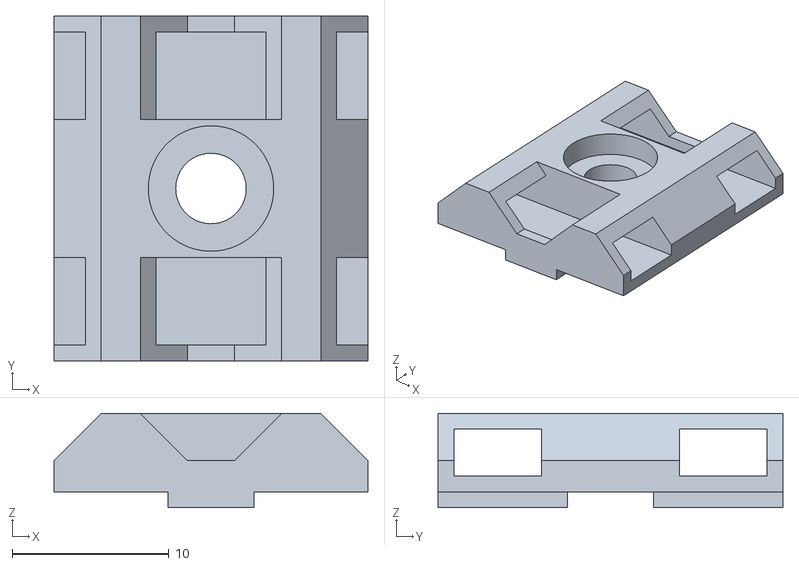
[picture p23: CAD file, 2015-03-06]
Printer/harness clip.stl
20.0 x 22.0 x 6.00
