CHIPKIT3DP-TEAM/mchp_kossel/Printer/big effector.stl

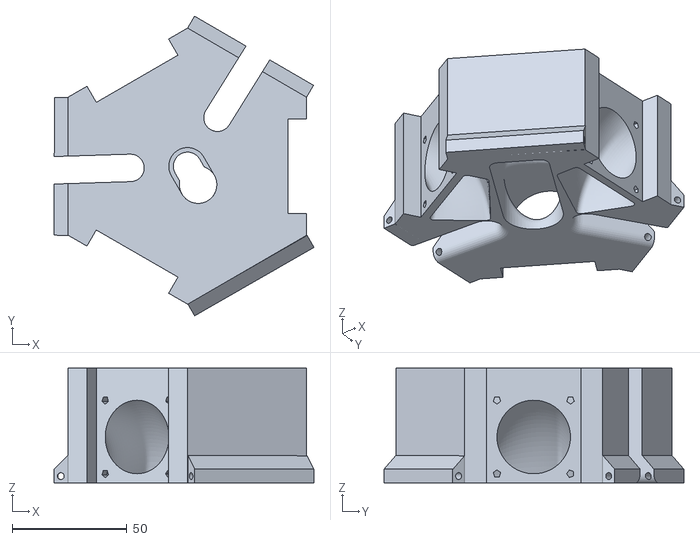
[picture p24: CAD file, 2015-02-28]
Printer/big effector.stl
113.1 x 130.4 x 50.0
