CHIPKIT3DP-TEAM/mchp_kossel/Printer/effector/ubis fitting hub.stl

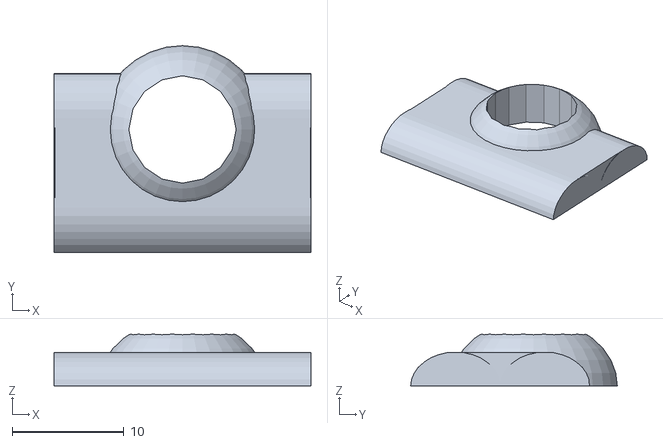
[picture p25: CAD file, 2015-05-12]
Printer/effector/ubis fitting hub.stl
23.0 x 18.5 x 4.63
