CHIPKIT3DP-TEAM/mchp_kossel/Printer/big plug.stl

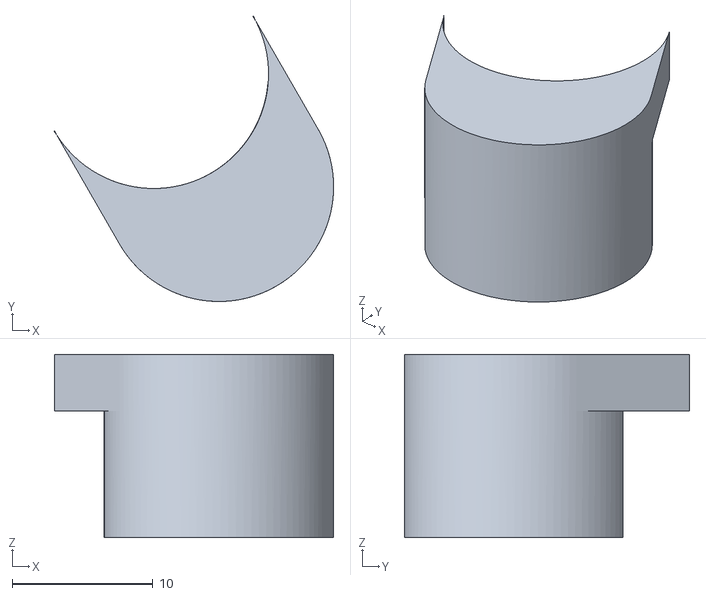
[picture p26: CAD file, 2015-02-28]
Printer/big plug.stl
19.8 x 20.2 x 13.0
