CHIPKIT3DP-TEAM/mchp_kossel/Printer/effector/ubis plug.stl

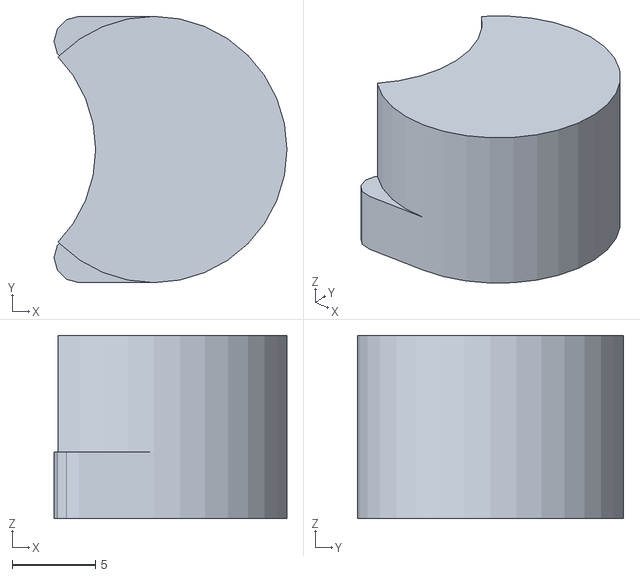
[picture p27: CAD file, 2015-05-12]
Printer/effector/ubis plug.stl
14.0 x 16.0 x 11.0
