CHIPKIT3DP-TEAM/mchp_kossel/Printer/glass clamp.stl

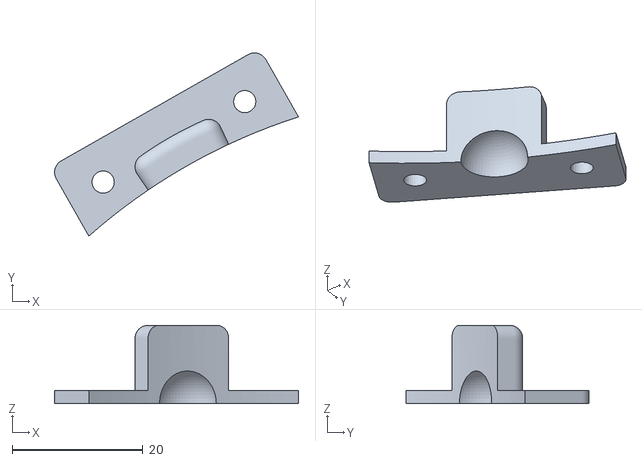
[picture p28: CAD file, 2015-02-07]
Printer/glass clamp.stl
37.4 x 28.1 x 12.0
