CHIPKIT3DP-TEAM/mchp_kossel/Printer/lower corner.stl

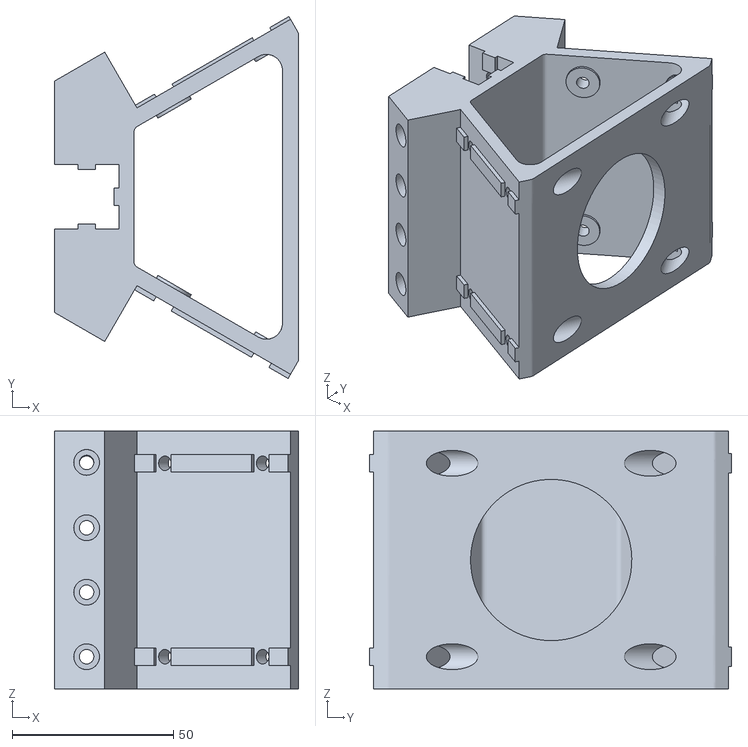
[picture p29: CAD file, 2015-02-04]
Printer/lower corner.stl
75.7 x 112.3 x 80.0
