CHIPKIT3DP-TEAM/mchp_kossel/(list of files, cad)

Other CAD files:
Printer/top corner.stl
Printer/extruder/parametric_involute_gear_v5.1.scad
Printer/240 beam.ipt
Printer/600 beam.ipt
Printer/M4x25.ipt
Printer/OldVersions/Carraige.0006.ipt
Printer/OldVersions/big plug.0001.ipt
Printer/OldVersions/bottom pcb.0003.ipt
Printer/OldVersions/build deck.0007.ipt
Printer/OldVersions/glass clamp.0002.ipt
Printer/OldVersions/harness clip.0001.ipt
Printer/OldVersions/large wall.0007.ipt
Printer/OldVersions/linear slide.0009.iam
Printer/OldVersions/lower corner.0001.idw
Printer/OldVersions/lower corner.0023.ipt
Printer/OldVersions/printer corner.0023.iam
Printer/OldVersions/printer.0004.idw
Printer/OldVersions/printer.0017.iam
Printer/OldVersions/slide.0001.ipt
Printer/OldVersions/small side.0002.ipt
Printer/OldVersions/small side.0003.ipt
Printer/OldVersions/stopclamp.0012.ipt
Printer/OldVersions/top corner.0015.ipt
Printer/big effector.ipt
Printer/big plug.ipt
Printer/build deck.iam
Printer/build deck.idw
Printer/build deck.ipt
Printer/carraige.ipt
Printer/effector plate.ipt
Printer/effector plug.ipt
Printer/glass clamp.ipt
Printer/glass.ipt
Printer/harness clip.ipt
Printer/large wall.ipt
Printer/lead carriage.ipt
Printer/linear slide.iam
Printer/linear stepper.iam
Printer/lower corner.idw
Printer/lower corner.ipt
Printer/motor.ipt
Printer/optical stop.ipt
Printer/printer corner.iam
Printer/printer.iam
Printer/printer.idw
Printer/slide rail.ipt
Printer/slide.ipt
Printer/small side.ipt
Printer/small wall.ipt
Printer/stopclamp.ipt
Printer/supply base.ipt
Printer/supply shield.ipt
Printer/supply.iam
Printer/top corner.ipt
