CHIPKIT3DP-TEAM/mchp_kossel/Printer/acrylic/bottom plate.pdf

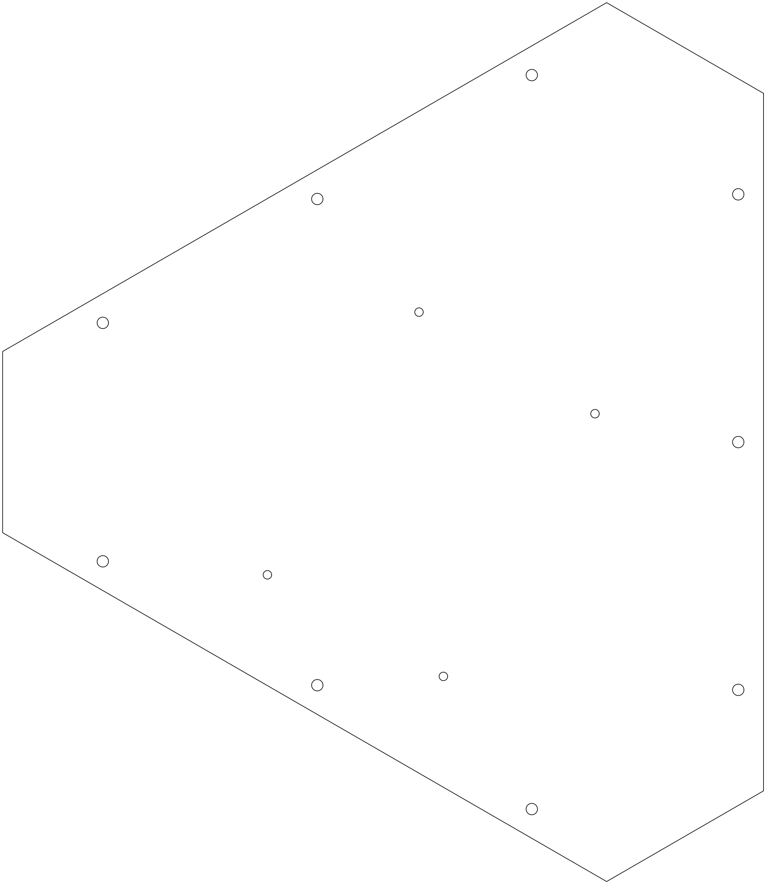
[picture p30: figure]
