CHIPKIT3DP-TEAM/mchp_kossel/Printer/acrylic/large wall.pdf

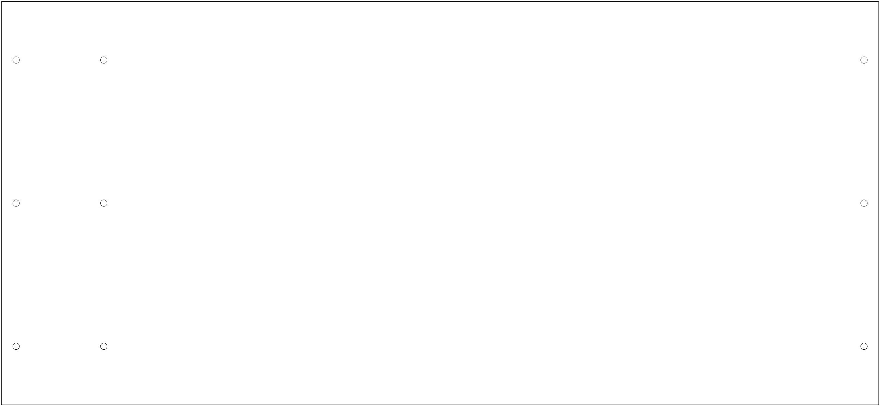
[picture p31: figure]
