CHIPKIT3DP-TEAM/mchp_kossel/Printer/acrylic/small wall.pdf

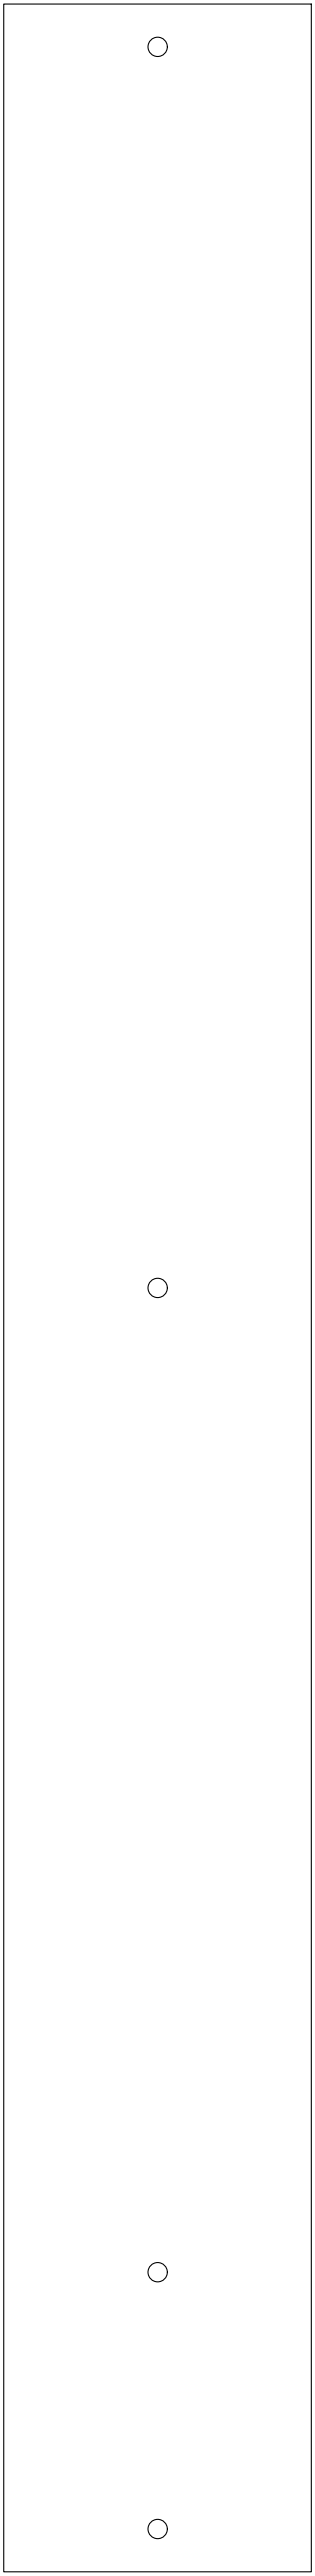
[picture p32: figure]
