CHIPKIT3DP-TEAM/mchp_kossel/Printer/acrylic/top plate.pdf

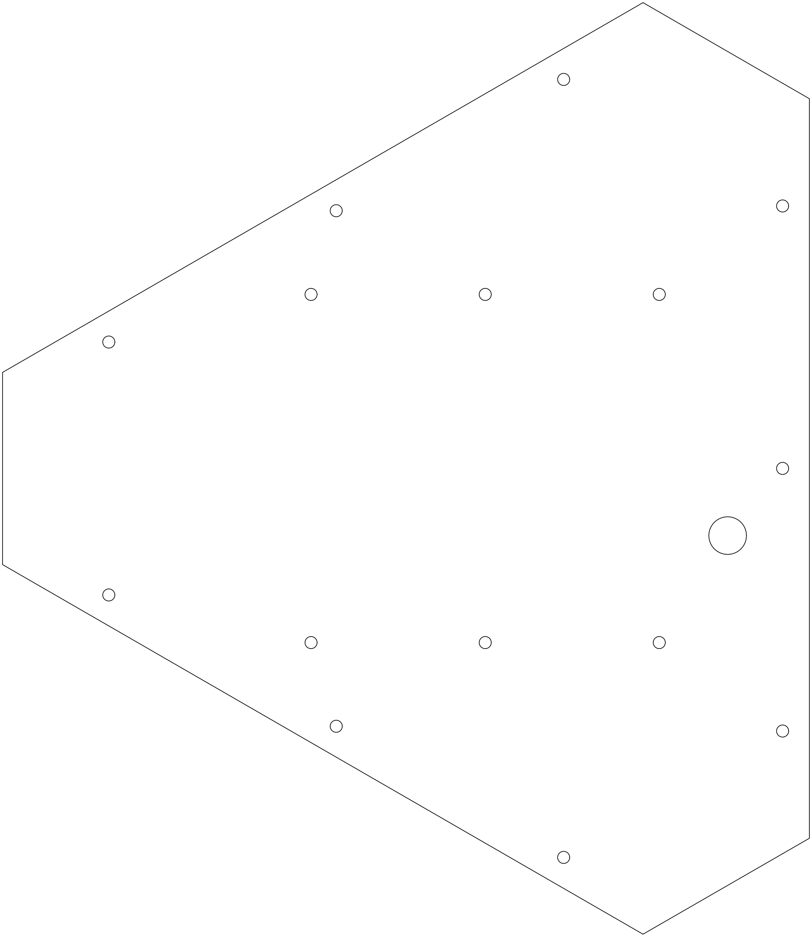
[picture p33: figure]
