CHIPKIT3DP-TEAM/mchp_kossel/Printer/printer.png

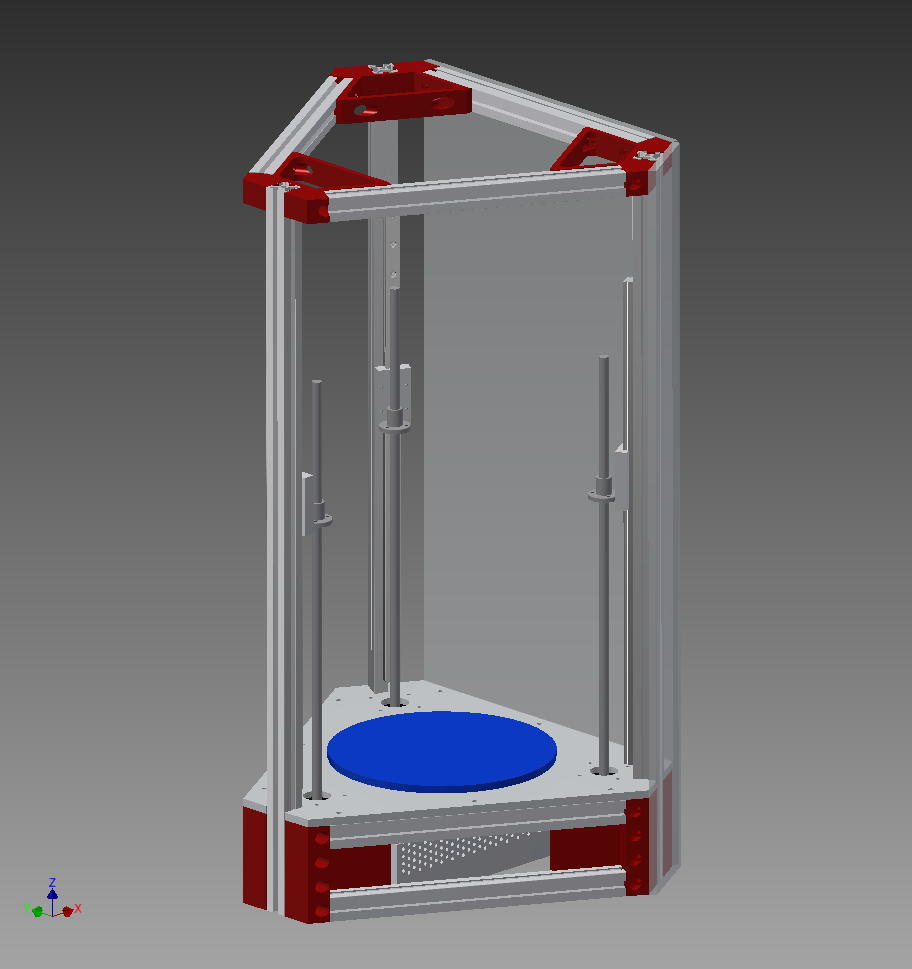
Printer/printer.png
