CHIPKIT3DP-TEAM/mchp_kossel/Printer/printer.pdf

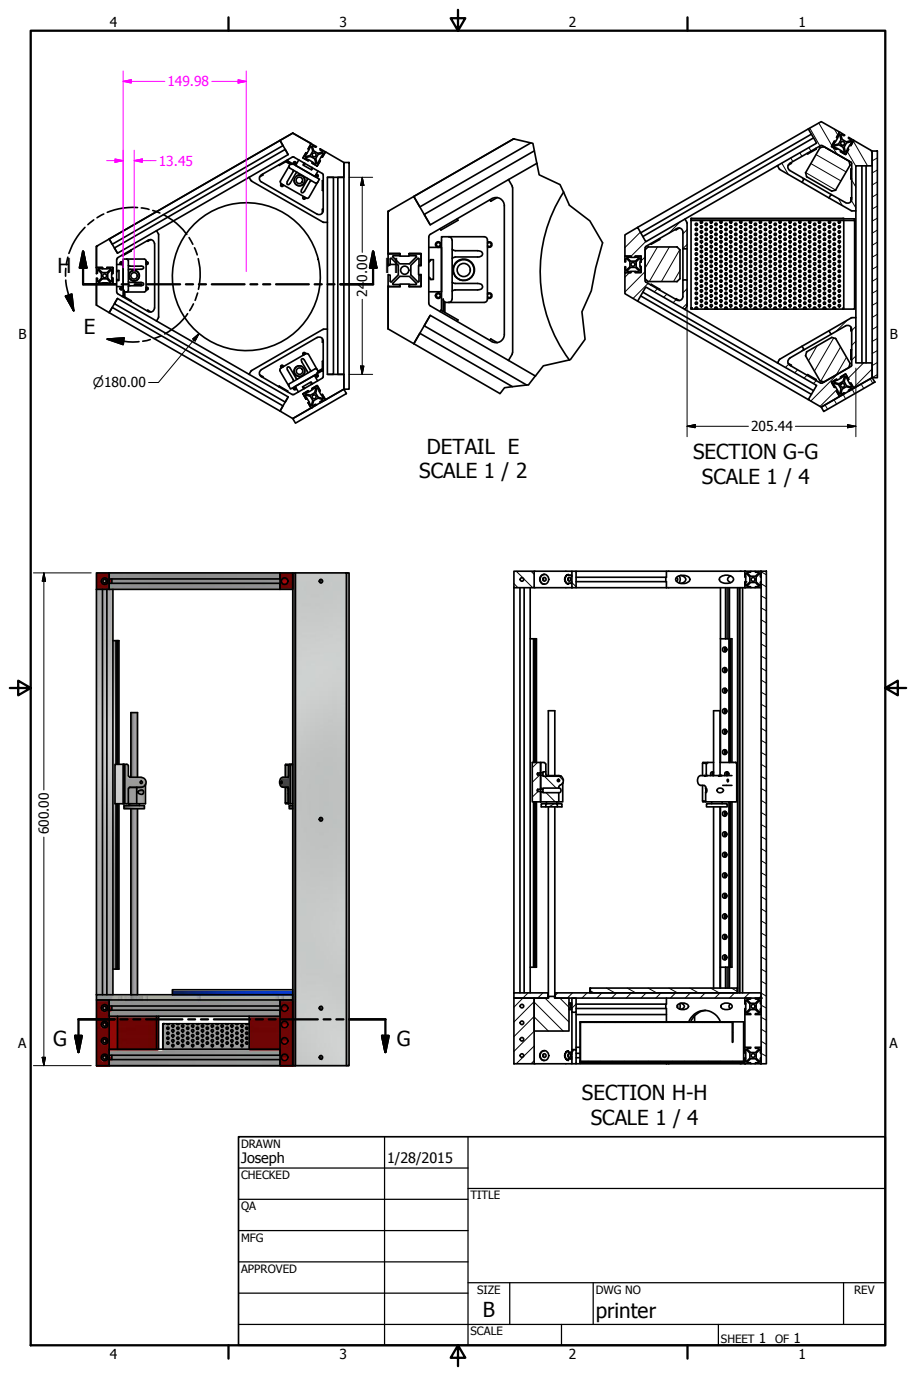
[picture p35: page 1]
DETAIL E SCALE 1 / 2; SECTION G-G SCALE 1 / 4; SECTION H-H SCALE 1 / 4; SHEET 1 OF 1; DRAWN; CHECKED; MFG; APPROVED; Joseph; DWG NO printer; TITLE; SIZE B; SCALE; REV
