CHIPKIT3DP-TEAM/mchp_kossel/firmware-struct.pdf

### commands / events / data

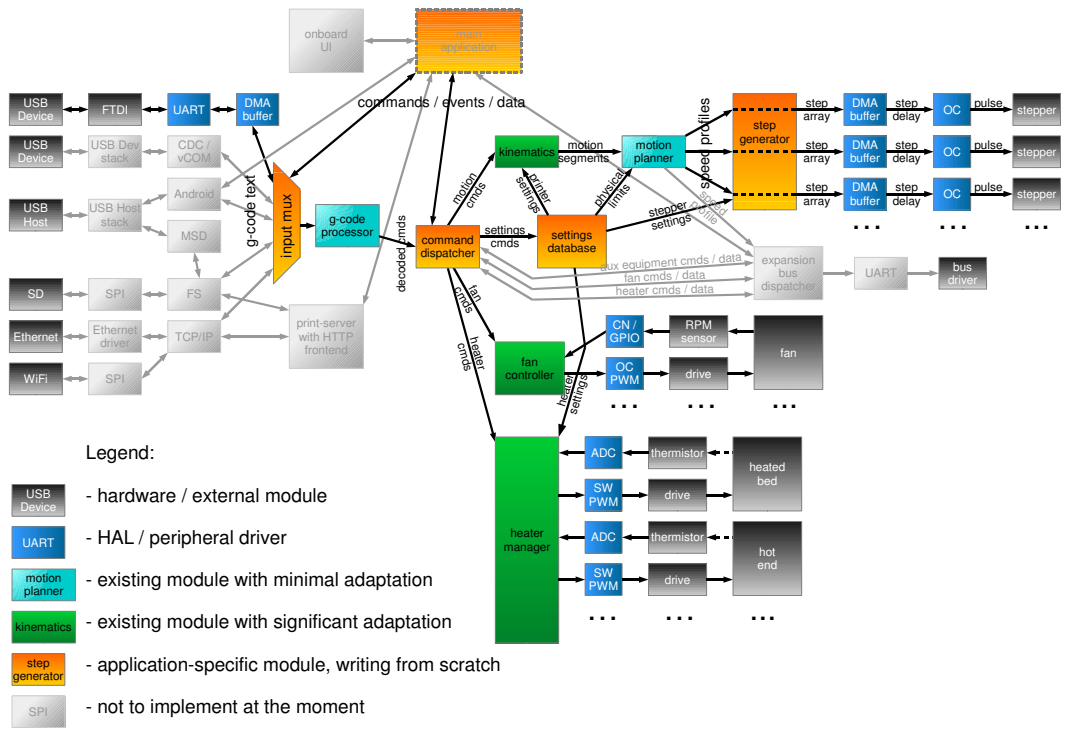
[picture p36: page 1]
USB Dev stack; SPI; CDC / vCOM; USB Device; g-code processor; onboard UI; motion cmds; fan cmds; heater cmds; kinematics; motion segments; motion planner; step; generator; array; DMA buffer; delay; pulse; stepper; settings; cmds; settings database; stepper step array; step array; command dispatcher; heater manager; ADC; thermistor; drive SWPWM; heated bed; heater settings; hot end; fan controller; RPM sensor; CN / GPIO; fan; Ethernet; driver Ethernet; TCP/IP; WiFi; FTDI; USB Host stack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

UART USB Device

physical limits printer settings stepper

aux equipment cmds / data UART

fan cmds / data

heater cmds / data

drive OC PWM

- hardware / external module

- HAL / peripheral driver

- existing module with minimal adaptation

- existing module with significant adaptation

- application-specific module, writing from scratch

- not to implement at the moment
