CHIPKIT3DP-TEAM/mchp_kossel/Printer/acrylic/build deck.pdf

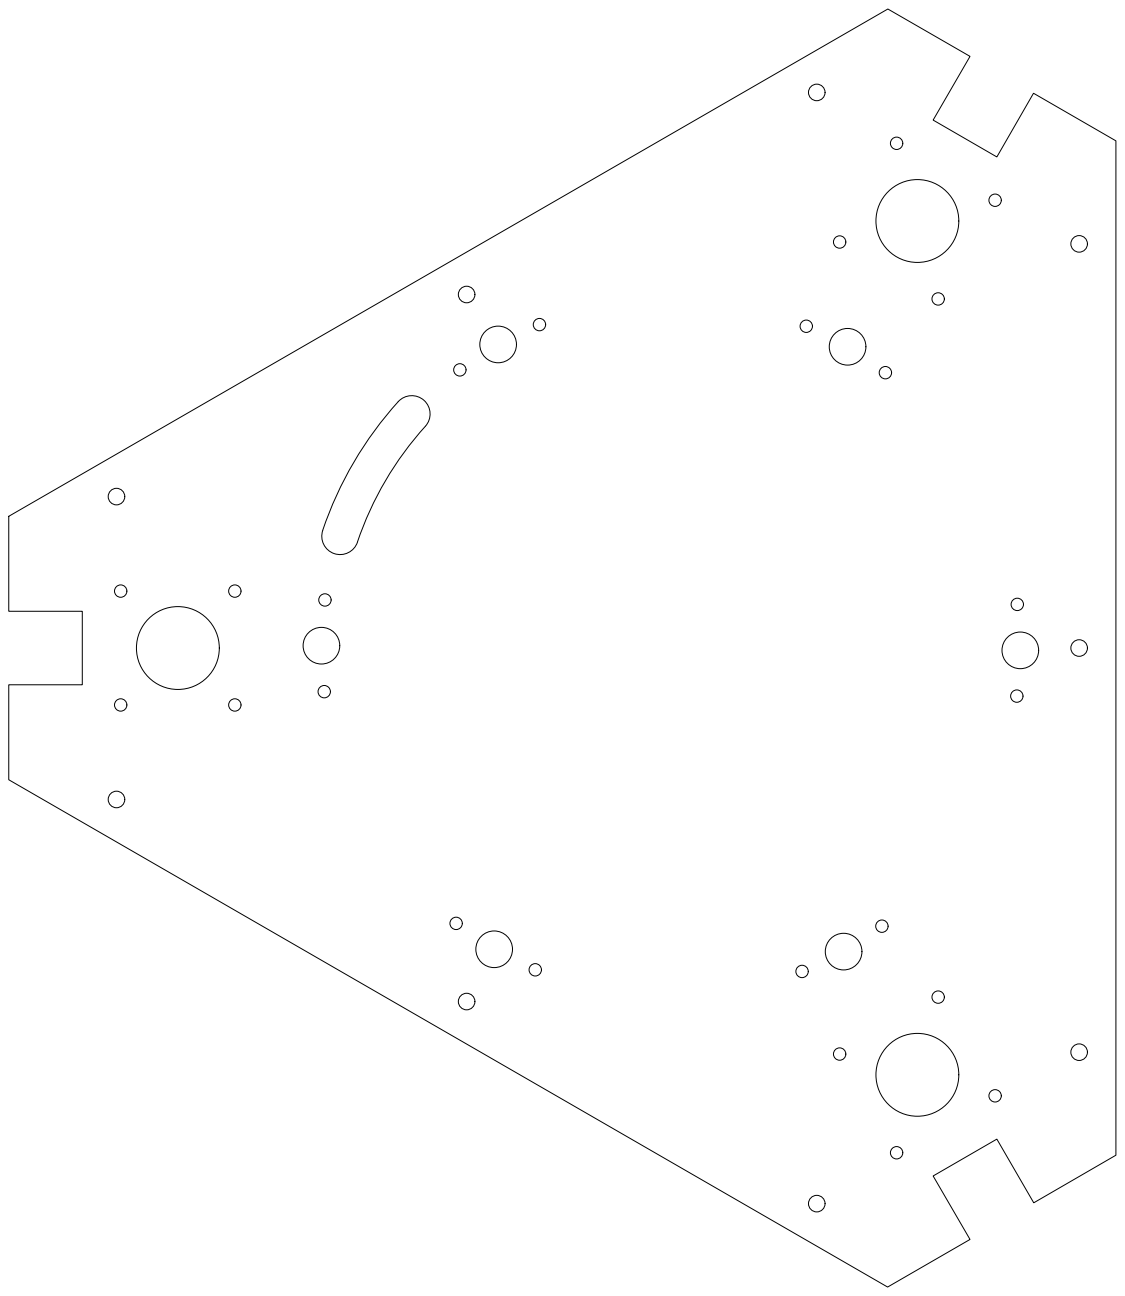
[picture p37: page 1]
