CHIPKIT3DP-TEAM/mchp_kossel/board/output/shield3DP-A0.asm.pdf

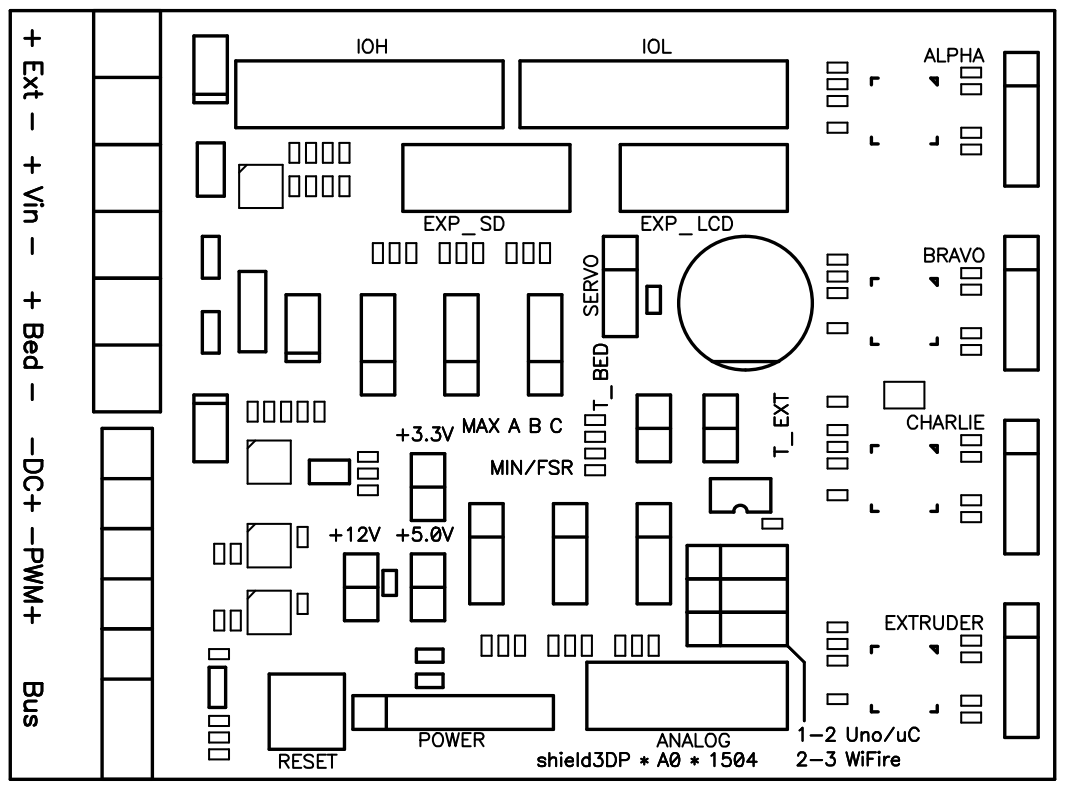
[picture p38: page 1]
