CHIPKIT3DP-TEAM/mchp_kossel/board/output/shield3DP-A0.bot.pdf

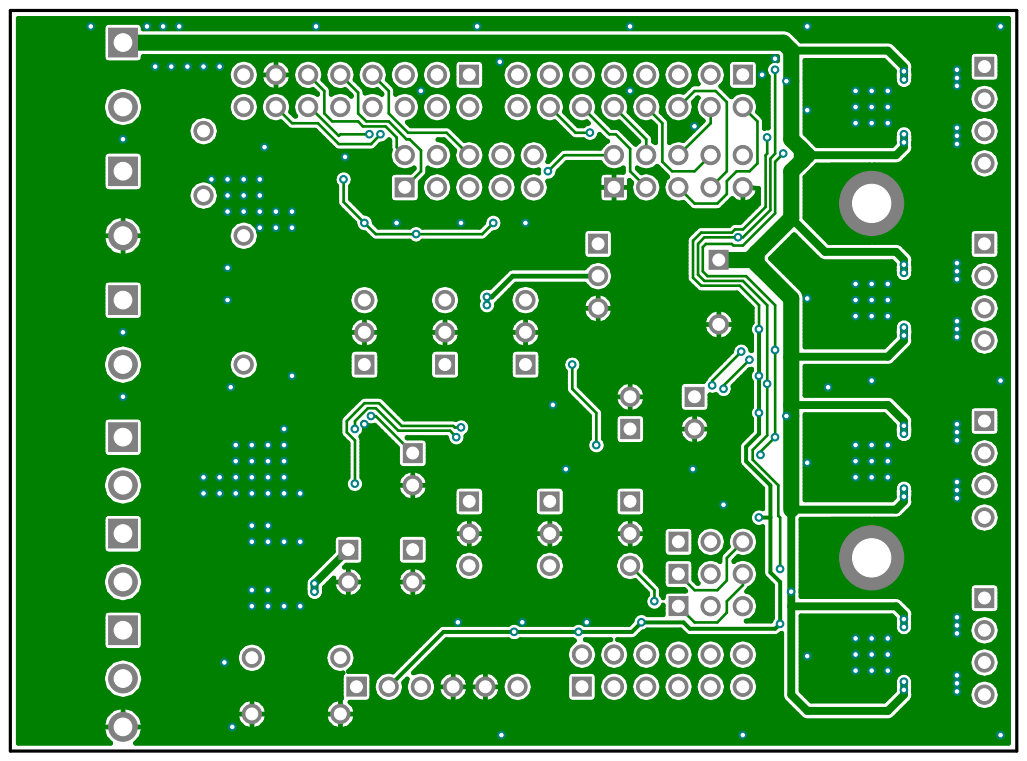
[picture p39: page 1]
