CHIPKIT3DP-TEAM/mchp_kossel/board/output/shield3DP-A0.sch.pdf

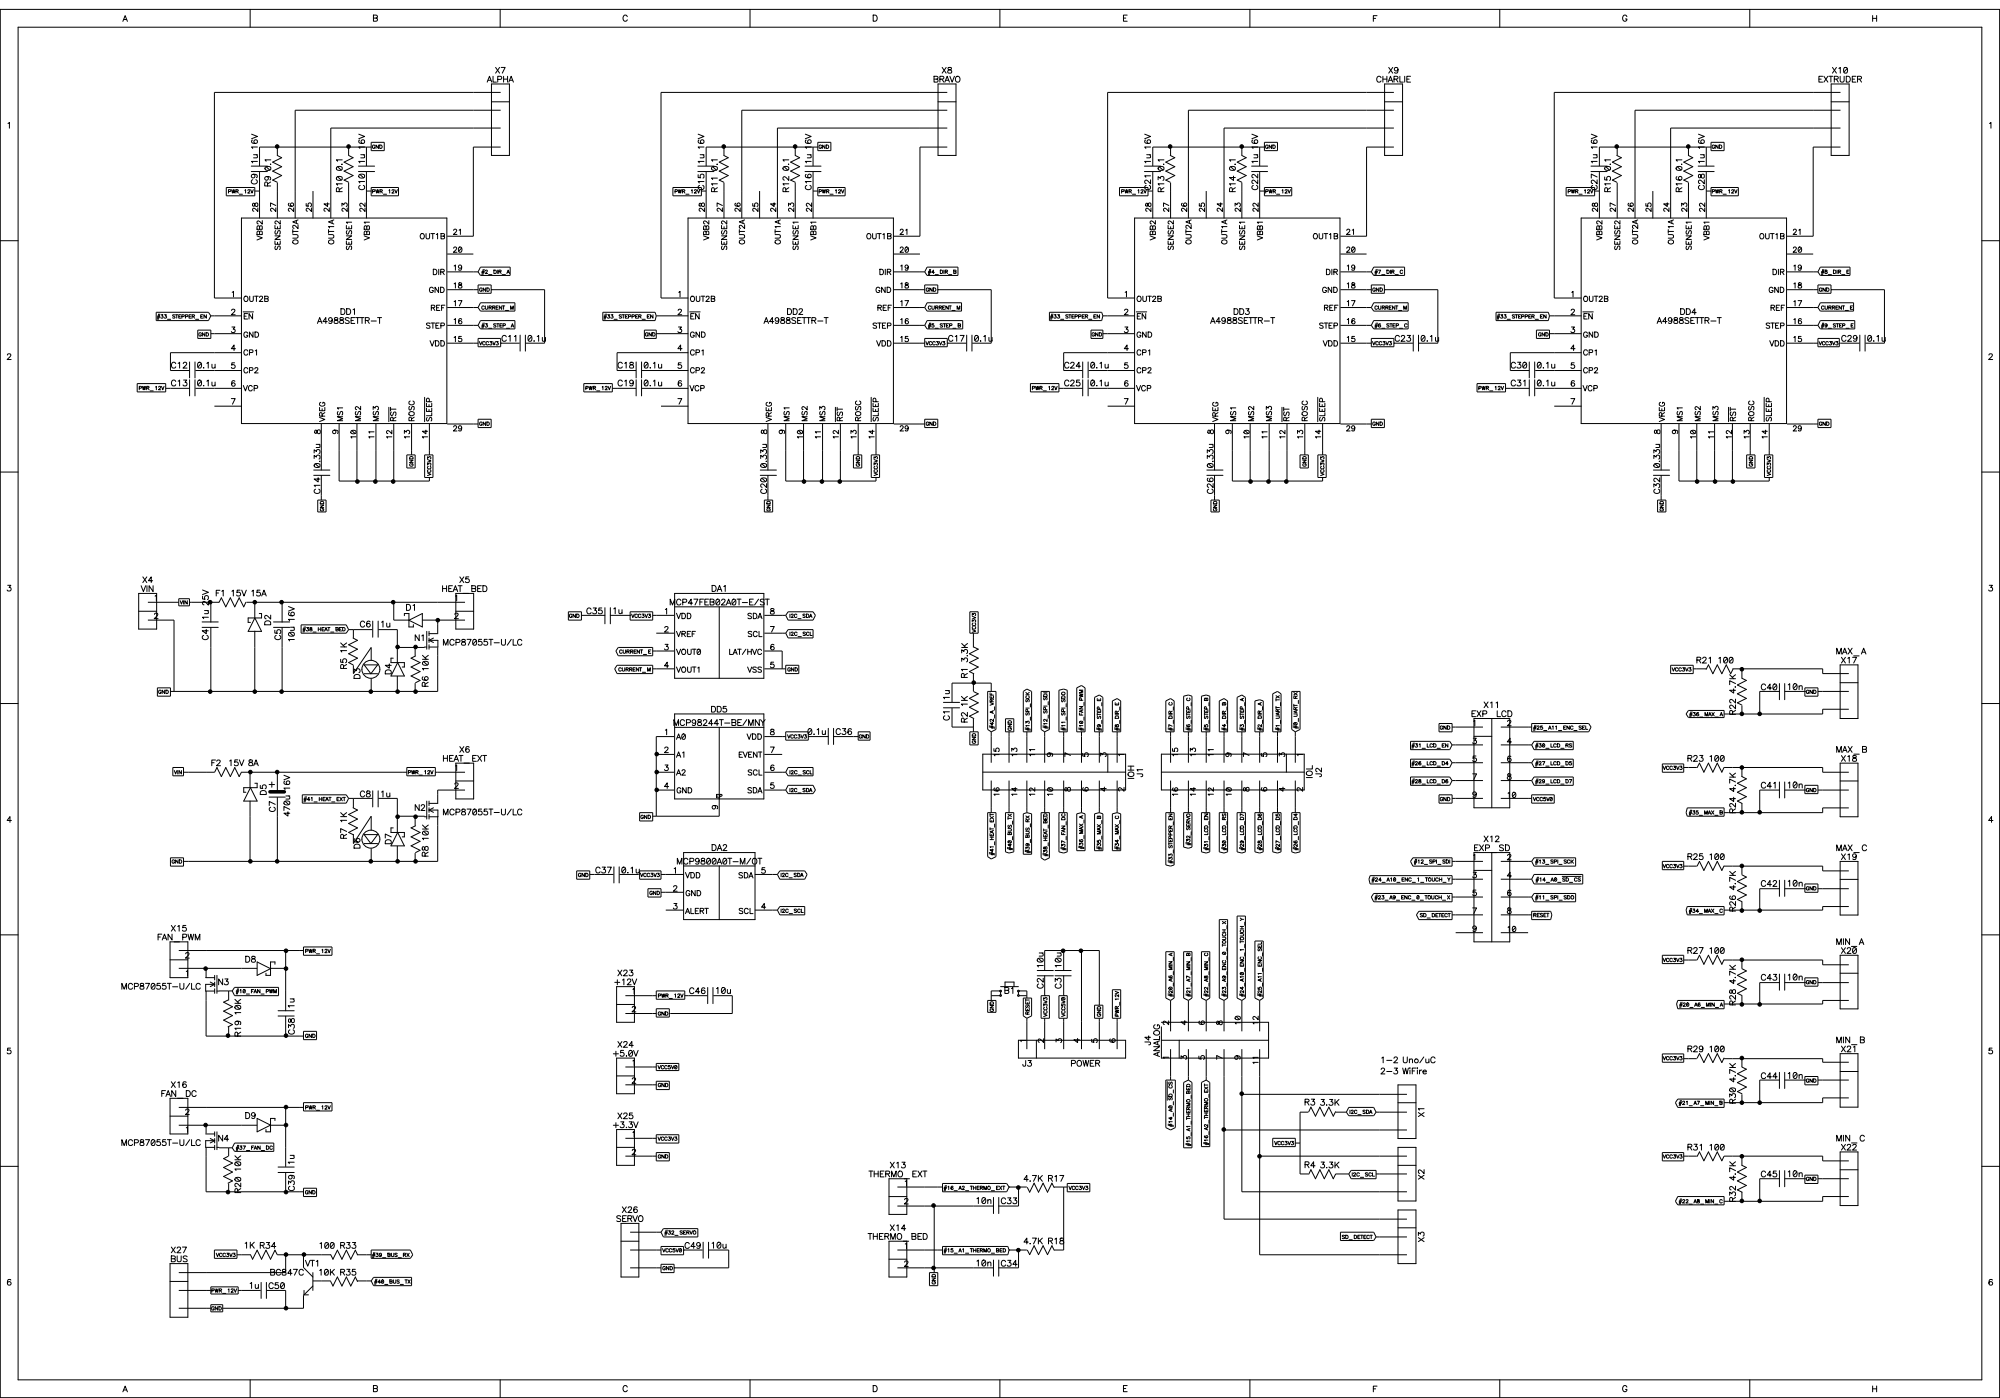
[picture p40: page 1]
