CHIPKIT3DP-TEAM/mchp_kossel/board/output/shield3DP-A0.top.pdf

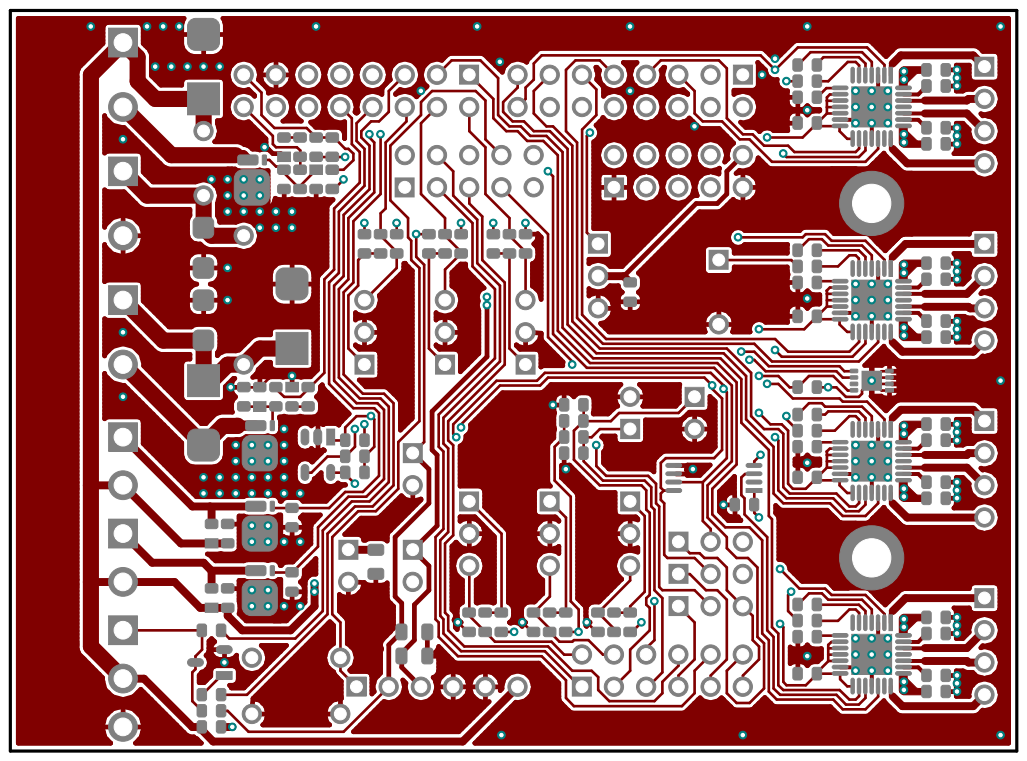
[picture p41: page 1]
