CHIPKIT3DP-TEAM/mchp_kossel/board/output/chipkit3dp-A0.pcb.pdf

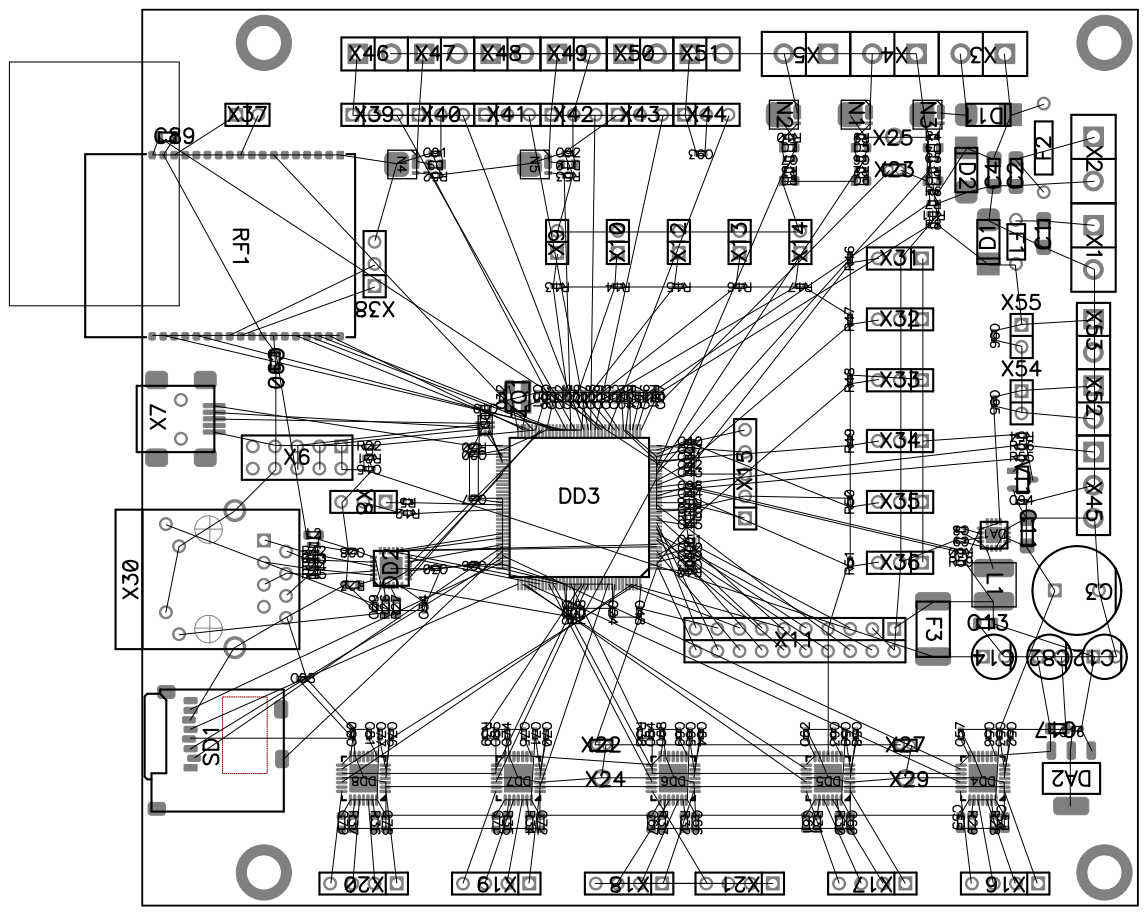
[picture p42: page 1]
