CHIPKIT3DP-TEAM/mchp_kossel/board/output/chipkit3dp-A0.sch.pdf

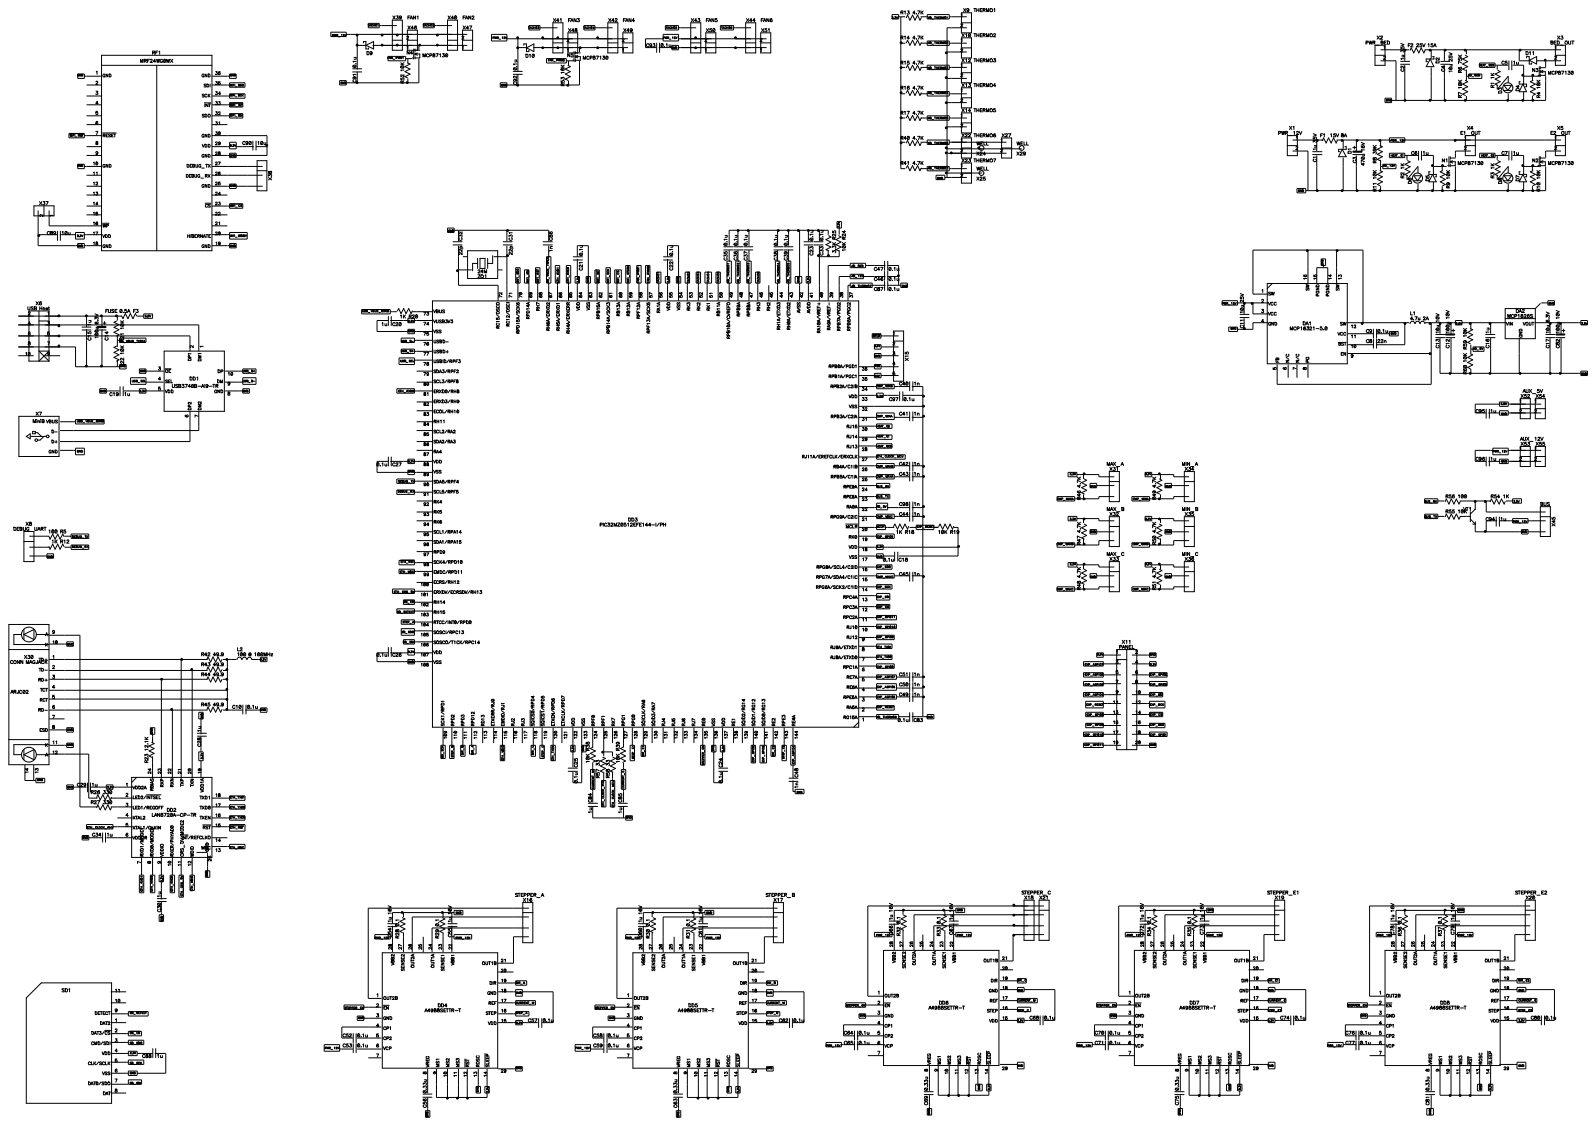
[picture p43: page 1]
