CHIPKIT3DP-TEAM/mchp_kossel/(list of files, drawings)

Other design files:
board/chipkit3dp-A0.PCB
board/chipkit3dp-A2.PCB
board/shield3dp-A0.PCB
board/shield3dp-A2.PCB
