CHIPKIT3DP-TEAM/mchp_kossel/(commit log)

2015-01-31 First Checkin
    All the inventor files for the printer chassis
    [240 beam.ipt, 600 beam.ipt, build deck.dwg, build deck.iam, build deck.ipt, glass.ipt, large wall.0006.ipt, large wall.ipt]
2015-02-01 Modified lower corner
    Added a hole for the motor wires in the lower corner
    [lower corner.0016.ipt, lower corner.ipt]
2015-02-01 corner updates
    added a mouse hole to the lower corner for wires in the extrusion.
    Corrected a t-slot hole in the upper corner piece.
    but a slight fillet on inside corners for smoother printing.
    [lower corner.0016.ipt, lower corner.0017.ipt, lower corner.ipt, lower corner.stl, top corner.0008.ipt, top corner.ipt, top corner.stl]
2015-02-01 corrected the M4 cap screw holes
    M4 head is 7.4mm according to STP files from vendor
    Made new M4 openings 8mm
    [M4x25.ipt, lower corner.0017.ipt, lower corner.0019.ipt, lower corner.ipt, lower corner.stl, top corner.0008.ipt, top corner.0010.ipt, top corner.ipt]
2015-02-03 Added the Slide Carriage
    This carriage is the link to the end effecter.
    [Carraige.ipt, build deck.0004.ipt, build deck.ipt, linear slide.0006.iam, linear slide.iam, printer corner.0015.iam, printer corner.iam, printer.0003.idw]
2015-02-03 STL file for the Carriage
    [Carraige.stl]
2015-02-03 Carriage Screw Holes
    Now this will screw to the lead screw carrier.
    Screw holes are a bit small... Use a Sheet metal screw for a tight fit.
    [Carraige.0002.ipt, Carraige.ipt, Carraige.stl]
2015-02-03 New. first check in
    [3D_Kossel_Hardware_BOM.xlsx]
2015-02-04 updated the corners
    learned a few things about the corners when the first unit was
    assembled. Updated the STL's as a result.
    [lower corner.0019.ipt, lower corner.0022.ipt, lower corner.idw, lower corner.ipt, lower corner.stl, top corner.0010.ipt, top corner.0011.ipt, top corner.ipt]
2015-02-04 fixed up the pdf and the corners.
    readjusted the printer size in the corners.
    [build deck.0004.ipt, build deck.0005.ipt, build deck.ipt, large wall.0006.ipt, large wall.0007.ipt, large wall.ipt, linear slide.0006.iam, linear slide.0007.iam]
2015-02-05 hardware resources redistributed: stepper drive redefined from software/DMA bitbang to OC; heater PWM changed to software
2015-02-06 added dwg of the build deck
    [Carraige.0002.ipt, Carraige.0003.ipt, Carraige.ipt, Carraige.stl, build deck.dwg, build deck.idw, lower corner.0001.idw, lower corner.idw]
2015-02-07 printer changes
    Widened the carriage to 60mm.
    added build plate mounting holes
    created a build plate clamp
    [Carraige.0003.ipt, Carraige.0006.ipt, Carraige.ipt, Carraige.stl, build deck.0005.ipt, build deck.0007.ipt, build deck.ipt, glass clamp.0002.ipt]
2015-02-08 project definition: 5V rail added for USB Host; stepper drive changed to OC. pinout.xls added
    [pinout.xls]
2015-02-10 current updates
    [chipkit3dp-A0.SCH, tft3dp-A0.SCH]
2015-02-10 p-cad libs added
2015-02-10 Updated, added Joes info from his 1st BOM
    [3D_Kossel_Hardware_BOM.xlsx]
2015-02-11 current update
    [chipkit3dp-A0.PCB, chipkit3dp-A0.SCH]
2015-02-14 144 pin package
    [chipkit3dp-A0.PCB, chipkit3dp-A0.SCH]
2015-02-17 Updates to the printer parts
    Carriage, effector plate & end stop updates
    [Carraige.ipt, Carraige.stl, effector plate.ipt, effector plate.stl, optical stop.ipt, printer corner.iam, printer.iam, stopclamp.ipt]
2015-02-17 added MRF24WG0MA
    [chipkit3dp-A0.PCB, chipkit3dp-A0.SCH]
2015-02-17 effector plate changes
    added a plug
    increased the j-head size slightly to account for print shrink.
    [effector plate.stl, effector plug.ipt, effector plug.stl]
2015-02-20 SCH / placement draft finished; passives changed to 0402
    [chipkit3dp-A0.PCB, chipkit3dp-A0.SCH]
2015-02-23 struct.odg added
    [chipkit3dp-A0.PCB]
2015-02-24 extruder model added
    [extr_body.stl, extr_bolt_emu.stl, extr_gear_big.stl, extr_gear_small.stl, extr_lever.stl, extr_pin.stl]
2015-02-24 PDFs added; minor PCB update
    [chipkit3dp-A0.PCB]
2015-02-27 spring wells diameter increased; lever spring cap angle corrected
    [extr_body.stl, extr_lever.stl]
2015-02-28 star effector plate adjustments
    [big effector.ipt, big effector.stl, big plug.0001.ipt, big plug.ipt, big plug.stl, harness clip.0001.ipt, harness clip.ipt, harness clip.stl]
2015-02-28 Cosmetic changes
    added a title & adjusted to D size paper
    [chipkit3dp-A0.SCH]
2015-03-02 more cosmetic changes in the schematics
    [chipkit3dp-A0.SCH]
2015-03-06 refinements in the harness clip
    The harness clip is to hold the wiring harness in place
    [harness clip.ipt, harness clip.stl]
2015-03-06 Update the BOM
    Changed the BOM format to Open Office
    [3D_Kossel_Hardware_BOM.ods, 3D_Kossel_Hardware_BOM.xlsx]
2015-03-07 NEMA17 drill pattern fixed; press fitting hole increased to 10 mm (~9.6 mm printed)
    [extr_body.stl]
2015-03-07 plate gcode removed
2015-03-18 more cosmetic changes to SCH
    [chipkit3dp-A0.SCH]
2015-03-23 SCH/PCB A2 introdued (based on original schematic), layout started; rearranged analog filter caps; changed passives from 0402 to 0603; rearranged expansion header and end stops wiring; minor correcti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
    [chipkit3dp-A2.PCB, chipkit3dp-A2.SCH]
2015-03-25 layout in progress
    [chipkit3dp-A2.PCB, chipkit3dp-A2.SCH]
2015-03-27 minor layout tweaks
    [chipkit3dp-A2.PCB]
2015-04-02 Pinout map for a UNO32/WiFire Shield
    This pinout is a minimal 4 motor drive for basic 3D Printer. Not as
    feature rich as the primary project but shorter schedule and enough for
    code porting work.
    [Light Version Pinout for UNO32 & WiFire.xlsx]
2015-04-03 Pinout Updates
    [Light Version Pinout for UNO32 & WiFire.xlsx]
2015-04-05 reviewed CHIPKIT_RAMPS pinout
    [Light Version Pinout for UNO32 & WiFire.xlsx]
2015-04-06 shield3DP: - pinout updated; - schematic drafted; chipkit3dp: - minor layout progress
    [Light Version Pinout for UNO32 & WiFire.ods, chipkit3dp-A2.PCB, shield3DP-A0.sch]
2015-04-07 shield: - SCH finished; - PCB started
    [chipkit3dp-A2.SCH, shield3DP-A0.sch, shield3dp-A0.PCB]
2015-04-07 minor tweaks
    [shield3DP-A0.sch, shield3dp-A0.PCB]
2015-04-08 shield layout in progress
    [chipkit3dp-A2.PCB, shield3DP-A0.sch, shield3dp-A0.PCB]
2015-04-09 schield3DP - placement finished
    [shield3DP-A0.sch, shield3dp-A0.PCB]
2015-04-09 shield3DP - topology layout started
    [shield3DP-A0.sch, shield3dp-A0.PCB]
2015-04-10 Shield Layout 40%
    Routed most of the high power signals.
    [shield3dp-A0.PCB]
2015-04-10 shield3DP layout in progress; Joe's modifications saved into A2
    [shield3DP-A0.sch, shield3dp-A0.PCB, shield3dp-A2.PCB]
2015-04-10 review notes added
    [shield3DP-A0.sch, shield3dp-A0.PCB]
2015-04-11 clean layout on the left side.
    Still routing the middle.
    [shield3dp-A2.PCB]
2015-04-11 More updates to the A2 Shield
    Mostly finished.
    [shield3dp-A2.PCB]
2015-04-13 shield3DP: - stepper section routed; - MOSFETs placement optimized.
    [shield3dp-A0.PCB]
2015-04-14 shiled3DP layout in progress
    [shield3DP-A0.sch, shield3dp-A0.PCB]
2015-04-14 shield3DP-A0 layout finished
    [shield3DP-A0.sch, shield3dp-A0.PCB]
2015-04-15 shield3DP - production version
    [shield3DP-A0.sch, shield3dp-A0.PCB]
2015-04-16 shield3DP: - minor tweaks; - silkscreen updated; - PDFs generated; - gerbers added
    [SHIELD3DP-A0.BRD, shield3DP-A0.sch, shield3dp-A0.PCB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]
2015-04-16 shield3DP: - PDFs moved to output folder; - BOM added; - MOSFETs changed to MCP87055
    [shield3DP-A0.sch, shield3dp-A0.PCB, shield3dp-A0.bom.ods]
2015-04-16 shield3DP: - .bom.pdf added
2015-04-25 updated the carriage for 44mm
    [Carraige.ipt, Carraige.stl]
2015-04-25 updated mounting holes; motor mounting pattern fixed
    [extr_body.stl]
2015-04-27 effector plate changed to donut 44 mm base; compatible hotend mount added; extruder body updated with wide intake and correct push fitting hole diameter
    [effector plate.stl, extr_body.stl, hotend mount.stl]
2015-04-29 acrylic parts: added top plate, bottom plate and insulator; moved to separate folder
    [bottom plate.dxf, build deck.dwg, insulator.dxf, large wall.dxf, small wall.dxf, top plate.dxf]
2015-05-01 added PDF versions of laser-cut parts
    [build deck.dwg, build deck.dxf]
2015-05-01 added gears and generation scripts; multiple minor updates to extruder body
    [Herringbone_gears_hi-res.scad, extr_body.stl, extr_gear_big_43.stl, extr_gear_small_13.stl, parametric_involute_gear_v5.1.scad]
2015-05-05 New Top Corner
    Integrated end stop mount into top corner
    [top corner.ipt, top corner.stl]
2015-05-06 Updated top corner
    relieved the end stop mount for the solder bumps on the endstop.
    [bottom pcb.0003.ipt, printer corner.0017.iam, printer corner.0023.iam, printer corner.iam, printer.0013.iam, printer.0017.iam, printer.iam, small side.0003.ipt]
2015-05-12 unresolvable conflict
    [Herringbone_gears_hi-res.scad]
2015-05-12 - multiple updates incl. new carriage, UBIS mount, extruder gears, cable clamps; - minor folder reorg.
    [Carraige.stl, Herringbone_gears_hi-res.scad, cable clamp 10mm.stl, cable clamp 5mm.stl, carraige.ipt, carraige.stl, e3d mount.stl, effector plate.stl]
2015-05-12 unneeded files removed
    [effector plate.stl, effector plug.stl, extr_bolt_emu.stl, extr_gear_big.stl, extr_gear_small.stl]
2015-05-14 - clamp 5mm - dimensions adjusted; - extruder bode - added hotend cable guide.
    [cable clamp 5mm.stl, extr_body.stl]
2015-05-22 J-Head mount and fan mount added
    [hot_end_fan_mount.stl, j-head mount.stl, j-head_plug.stl]
2015-06-02 cable guide updated
    [extr_body.stl]
2015-06-20 - E3D mount updated; - extruder gear adjusted
    [Herringbone_gears_hi-res.scad, e3d mount.stl, e3d plug.stl, extr_gear_big_43.stl]
2015-06-20 pinout spreadsheet updated for shield3dp
    [Light Version Pinout for UNO32 & WiFire.ods]
2015-06-25 RESET switch conection & label corrected
    [shield3DP-A0.sch]
2015-06-25 labels and silk screen corrected
    [shield3dp-A0.PCB]
2015-06-25 rev A2 introduced; fan connectors polarity fixed
    [shield3DP-A2.sch, shield3dp-A2.PCB]
2015-07-08 Speed fixes
    Added config.c for configuring the part to run at 200 MHz.
    [system.h]
2015-07-24 firmware0struct updated; GRBL project added for reusing sources
    [config.h, cpu_map.h, defaults.h]
2015-07-26 Added start of DMA files.
2015-07-28 initialization and interrupts fixed, runs stable; time.c changed to native 32 bit; config bits moved to system.h
    [main.c, system.c, system.h, time.c, time.h]
2015-07-28 Added UART6
    Added structures for 6th UART port on MZ.
2015-07-29 clocking fixed; interrupts resolved (_DefaultInterrupt issue remaining);
    [system.c, system.h]
2015-08-07 PPS configured; UARTs enabled and tested; printing helpers and bus driver template added
2015-08-07 updated version: - pinouts fixed to match reality - full PIC32 pinout added for WiFire
    [shield pinout.ods]
2015-08-07 del old files
    [Light Version Pinout for UNO32 & WiFire.ods, Light Version Pinout for UNO32 & WiFire.xlsx, pinout.xls]
2015-08-08 spi & i2c drivers added, dma updated - not tested
2015-08-09 changed to MZ-EF; bsp folder introduced; MCPxxx driver templates added
2015-08-11 screw break-up added
    [3D_Kossel_Hardware_BOM.ods]
2015-08-12 stopclamp removed; notched top corner added
    [stopclamp.stl, top corner notch.stl]
2015-08-14 mcp9800 driver finished / tested; minor restructuring; multiple minor fixes; additional warnings enabled, minor code cleanup
    [bus.c, bus.h, dma.c, dma.h, drive.c, i2c.c, i2c.h, main.c]
2015-08-16 mcp98244 temp sensor functionality added, tested; mcp9800 minor fixes
    [main.c, main.h, mcp9800.c, mcp9800.h, mcp98244.c, mcp98244.h]
2015-08-20 minor update to mcp98244 driver
2015-08-28 nvs reworked into dynamic
    [i2c.c, i2c.h, main.c, main.h, mcp98244.c, mcp98244.h, nvstorage.c, nvstorage.h]
2015-08-30 updated with 5mm through holes
    [e3d mount.stl, effector plate.stl, j-head mount.stl, ubis mount.stl]
2015-08-30 old fan mount removed
    [hot_end_fan_mount.stl, j-head plug.stl]
